blend3d/Inventor-2040-W/STL/Dave's 2040 VL53L1x 0-Deg Bracket.stl

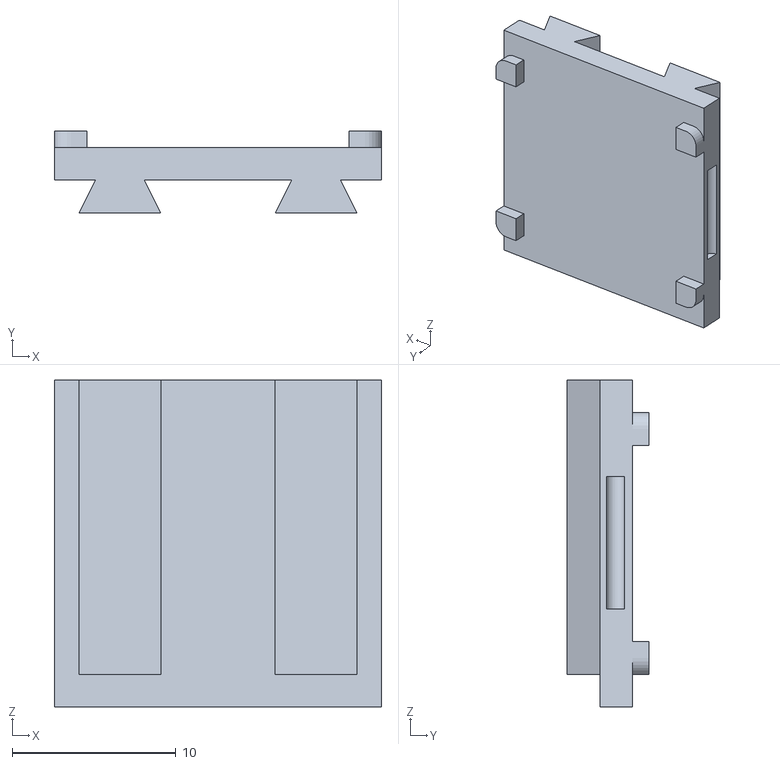
[picture p1: CAD file, 2026-10-23]
STL/Dave's 2040 VL53L1x 0-Deg Bracket.stl
20.0 x 5.00 x 20.0
