blend3d/Inventor-2040-W/STL/Dave's 2040 Travel Box Base r1.stl

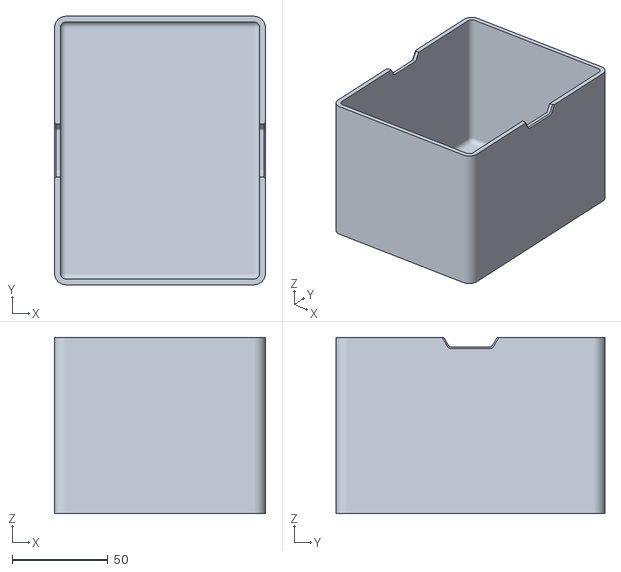
[picture p2: CAD file, 2026-10-19]
STL/Dave's 2040 Travel Box Base r1.stl
110.0 x 140.0 x 92.0
