blend3d/Inventor-2040-W/STL/Dave's 2040 Programming Stand r1.stl

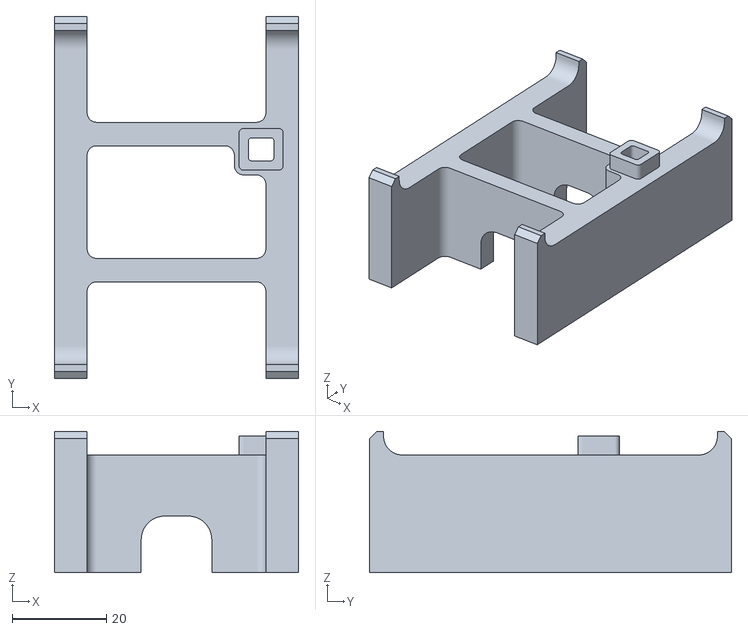
[picture p3: CAD file, 2026-10-19]
STL/Dave's 2040 Programming Stand r1.stl
52.0 x 77.0 x 30.0
