blend3d/Inventor-2040-W/STL/Dave's 2040 Batt Hold w_Locks r1.stl

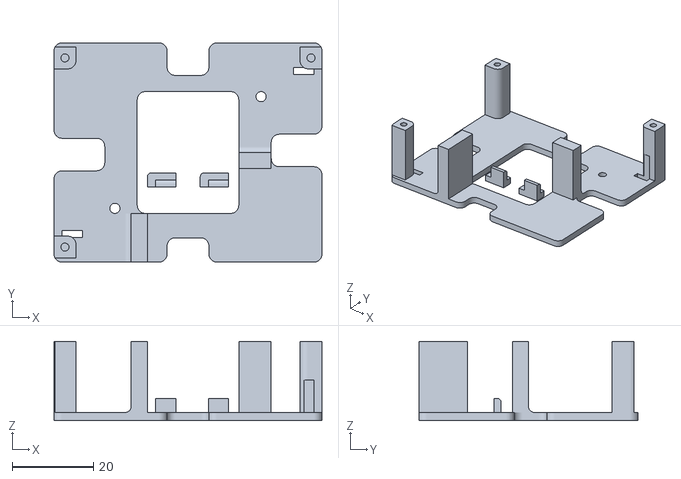
[picture p5: CAD file, 2026-05-22]
STL/Dave's 2040 Batt Hold w_Locks r1.stl
66.0 x 54.0 x 19.5
