blend3d/Inventor-2040-W/STL/Dave's 2040 Universal Front Bracket.stl

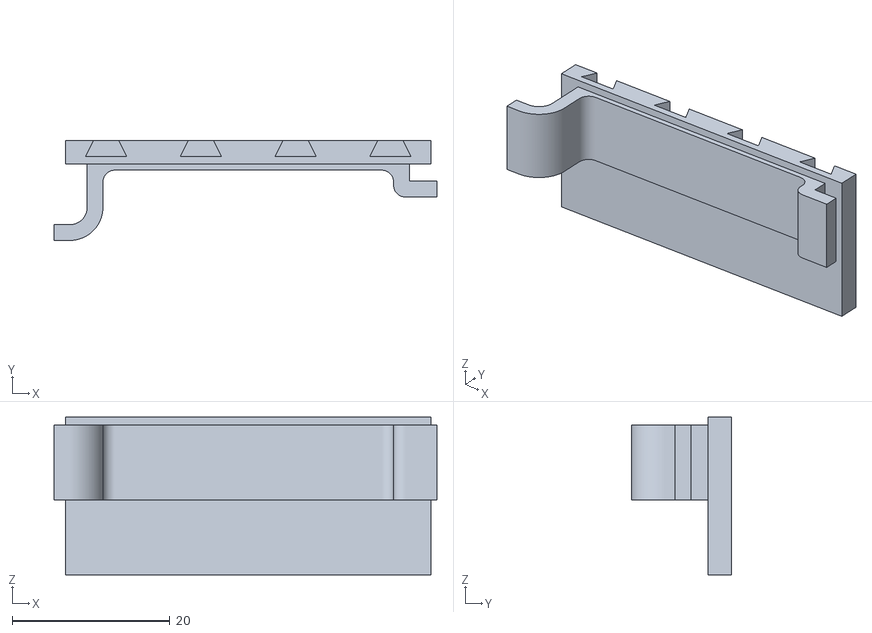
[picture p6: CAD file, 2026-05-22]
STL/Dave's 2040 Universal Front Bracket.stl
48.5 x 12.7 x 20.0
