blend3d/Inventor-2040-W/STL/Dave's 2040 VL53L1X Housing.stl

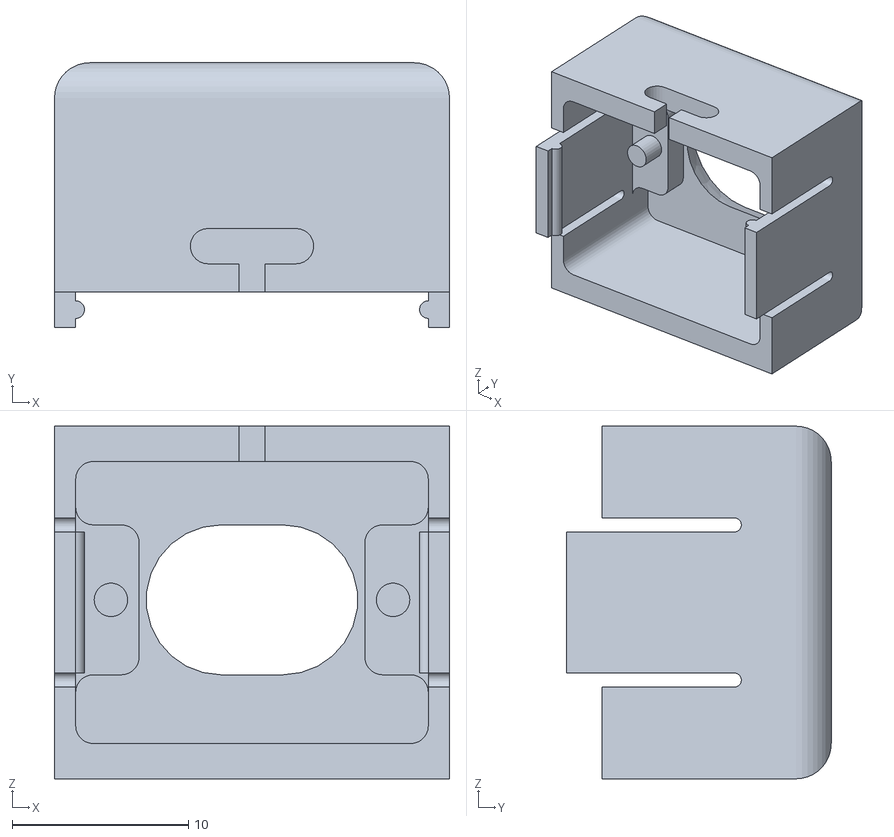
[picture p7: CAD file, 2026-05-22]
STL/Dave's 2040 VL53L1X Housing.stl
22.4 x 15.0 x 20.0
