blend3d/Inventor-2040-W/STL/Dave's 2040 24-Deg VL53L1X Mount Bracket.stl

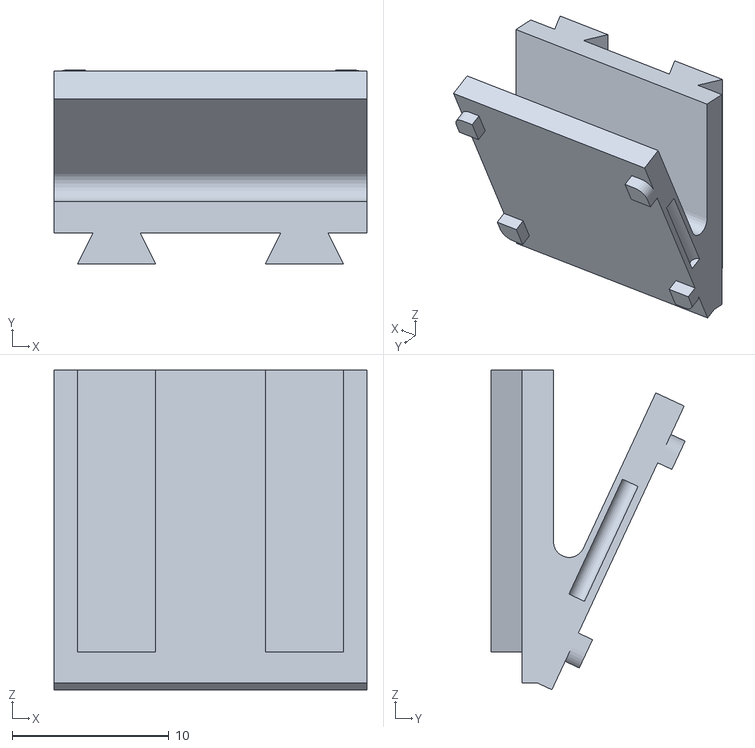
[picture p8: CAD file, 2026-05-22]
STL/Dave's 2040 24-Deg VL53L1X Mount Bracket.stl
20.0 x 12.4 x 20.4
