blend3d/Inventor-2040-W/STL/Dave's 2040 Chassis.stl

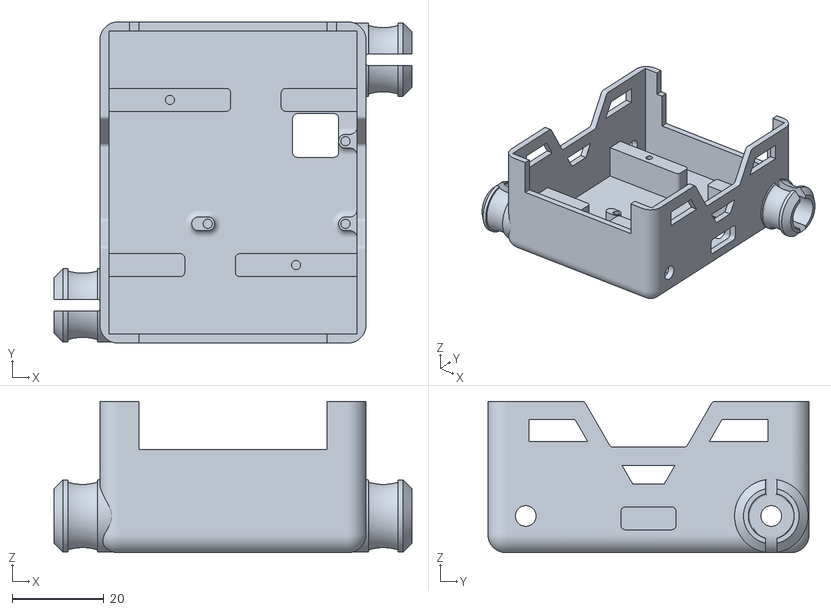
[picture p9: CAD file, 2026-05-22]
STL/Dave's 2040 Chassis.stl
78.0 x 70.0 x 33.0
