blend3d/Inventor-2040-W/STL/Dave's 2040 Sonar Bracket.stl

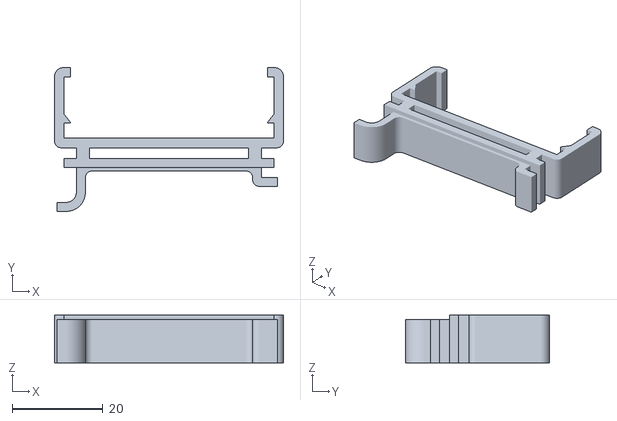
[picture p10: CAD file, 2026-05-22]
STL/Dave's 2040 Sonar Bracket.stl
50.4 x 31.6 x 10.5
