blend3d/Inventor-2040-W/(list of files, cad)

Other CAD files:
STL/Dave's 2040 Programming Stand.3mf
