blend3d/Inventor-2040-W/Build and Part Info/README.md

Pimoroni Inventor 2040/2350 W Board Information:

Github Repository - https://github.com/pimoroni/inventor

Library Reference - https://github.com/pimoroni/inventor/blob/main/docs/inventor.md

Micropython Examples - https://github.com/pimoroni/inventor/blob/main/examples/README.md

EzWiFi - https://github.com/pimoroni/inventor/blob/main/docs/ezwifi.md
