blend3d/Inventor-2040-W/Code/Basic Tests from Build PDF/README Astronauts and ISS.md

Create a lib directory (if not present) on your Pico W via Thonny.

Open the secrets.py file and insert your ssid and password between the quotes

Example:

    Change: ssid = "YOUR_WIFI_SSID"             To: ssid ="daves_router"
    Change: password = "YOUR_WIFI_PASSWORD"     To: password = "ou812#"

Once this is completed save the file. navigate to the lib folder on your pico and upload your secrets.py file.

Run the astronauts_and_iss_r2.py

Note: this project is pulling API json data from: http://open-notify.org/Open-Notify-API/
