blend3d/Inventor-2040-W/Build and Part Info/Inventor 2040 SMARS Build Guide.pdf

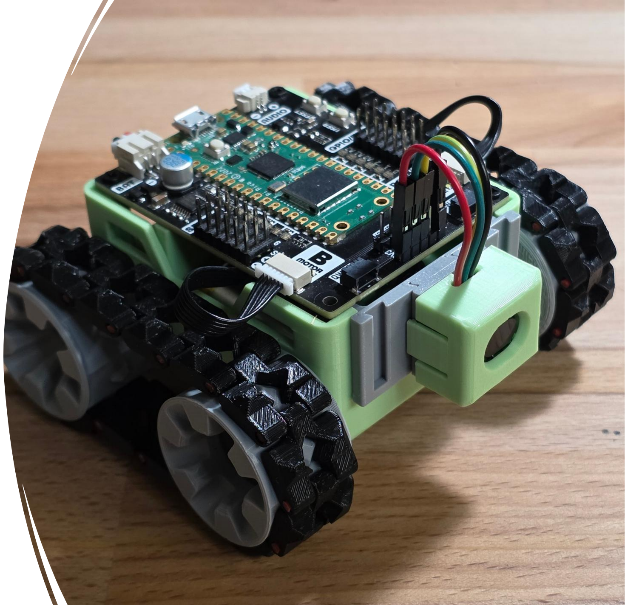
[picture p11: figure]

# Inventor

2040

# SMARS Build Guide

# Table of Contents

Build Guide:
1. Installing Charging PCBA and Battery
2. Install Motors
3. Install Battery Plate
4. Install Gearhead Motor Encoder Cables
5. Install Front Mounting Bracket
6. Assembling Speaker to Inventor 2040 PCBA
7. Installing Inventor 2040 PCBA
8. Install Slave Wheels
9. Assembling Tank Tracks
10. Installing Drive Wheels and Tank Tracks
11. Assembling VX53L1x Time of Flight (TOF) Sensor
12. Installing the VX53L1x TOF Sensor Assembly
13. Testing and Code Installation: Getting your SMARS to Come Alive

Appendix A: Component Information
Appendix B: Various Part Drawings

Installing Charging PCBA
and Battery

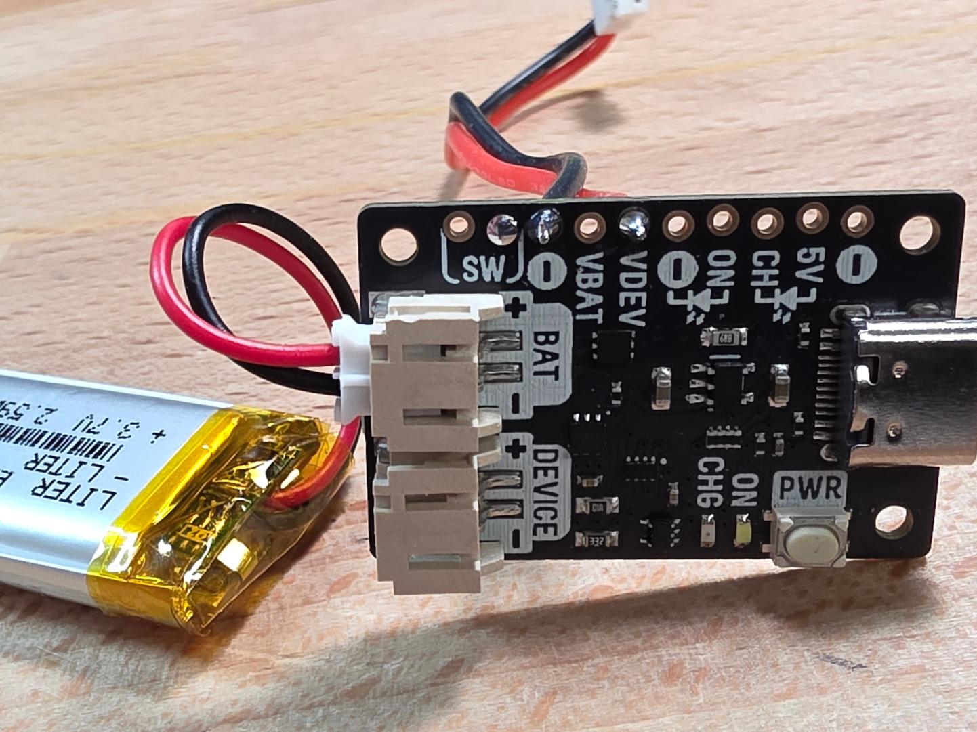
[picture p12: figure]

Plug the battery connector into the LiPo Amigo Pro Charging PCBA

Note: Polarity and Connector Orientation.

Test by pushing the PWR button. If correct the “ON” LED will light up white when on. Turn off before next steps.

Next plug into a USB C power source. The “CHG” LED should Illuminate red until battery is charged. Battery supplied was charged so the LED may not stay on very long.

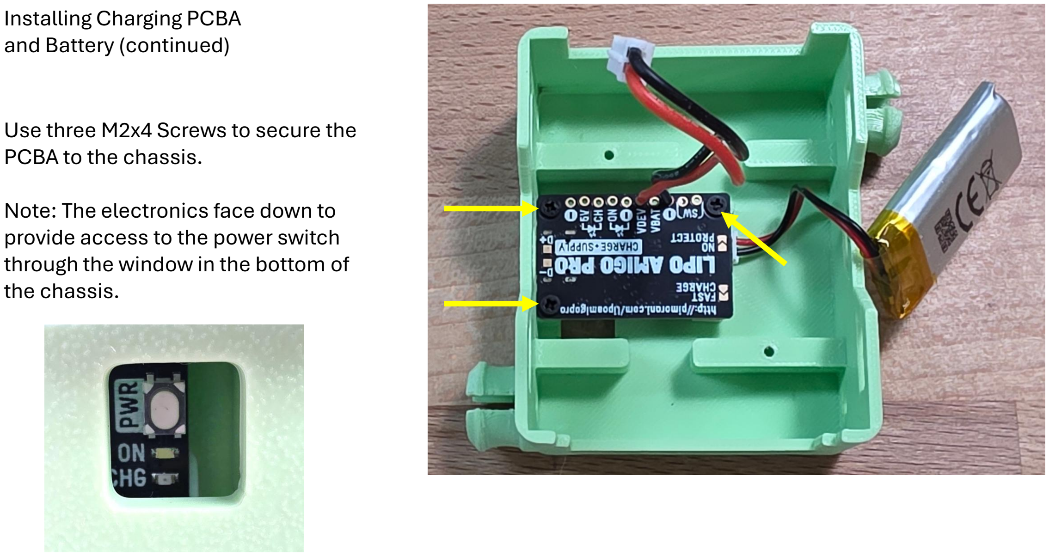
[picture p13: page 4]

Installing Charging PCBA
and Battery (continued)

Use three M2x4 Screws to secure the PCBA to the chassis.

Note: The electronics face down to provide access to the power switch through the window in the bottom of the chassis.

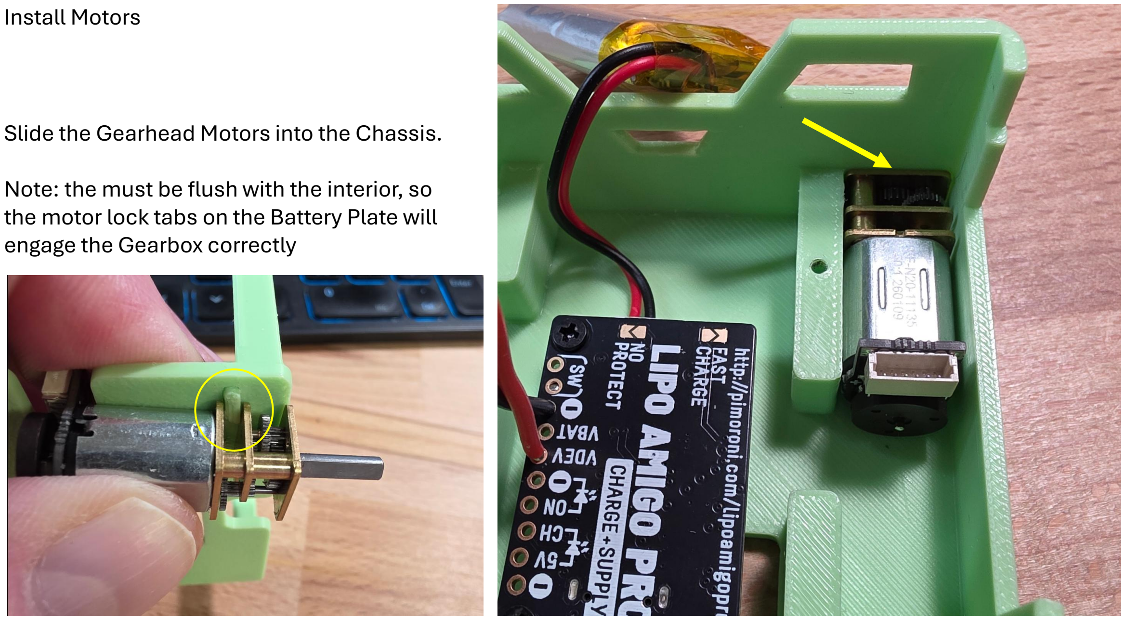
[picture p14: page 5]

Install Motors

Slide the Gearhead Motors into the Chassis.

Note: the must be flush with the interior, so the motor lock tabs on the Battery Plate will engage the Gearbox correctly

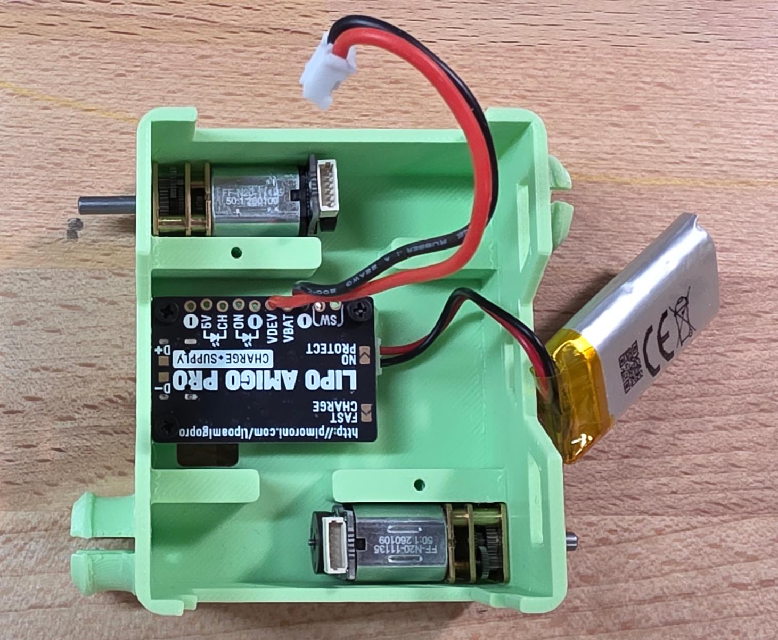
[picture p15: figure]

Install Motors (continued)

Your Chassis should look like this with the motors opposite each other and the power components in place.

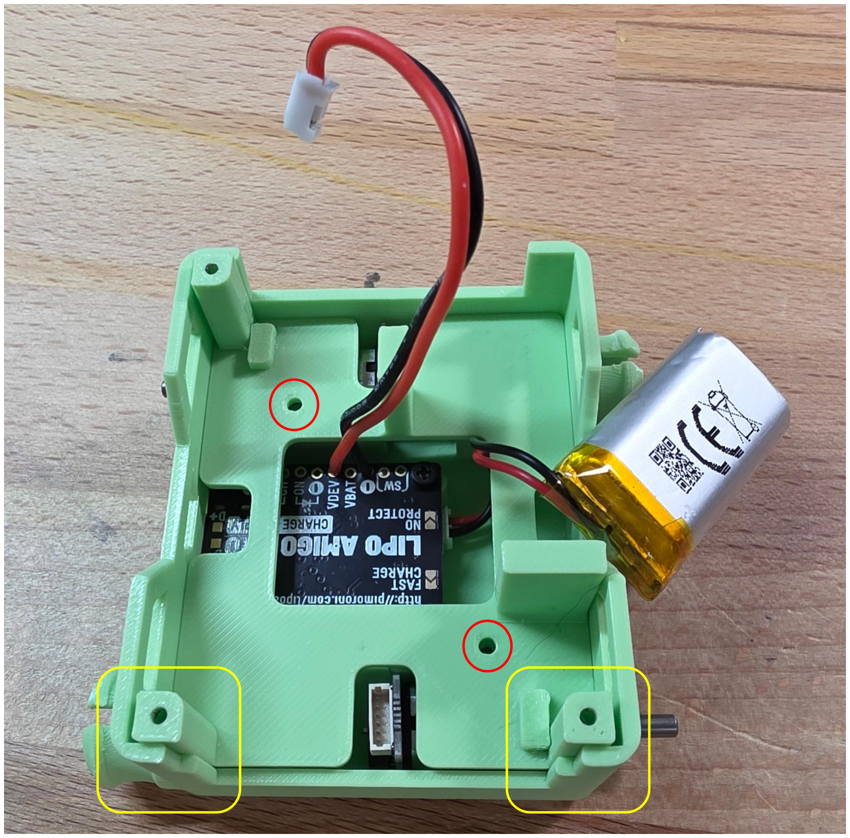
[picture p16: figure]

Install Battery Plate

Once the Gearhead Motors are in place install the Battery Plate as shown. Make sure that the Battery and Power wiring go through the center of the plate. Also, that the notched ends in the chassis have two mounting posts near them (yellow boxes).

Note: Ensure the Motors are flush with the interior, so the motor lock tabs on the Battery Plate will engage the Gearbox correctly. You can pull on the shafts as you push the plate into the chassis.

Once the plate is seated in place secure it with two screws (red circles).

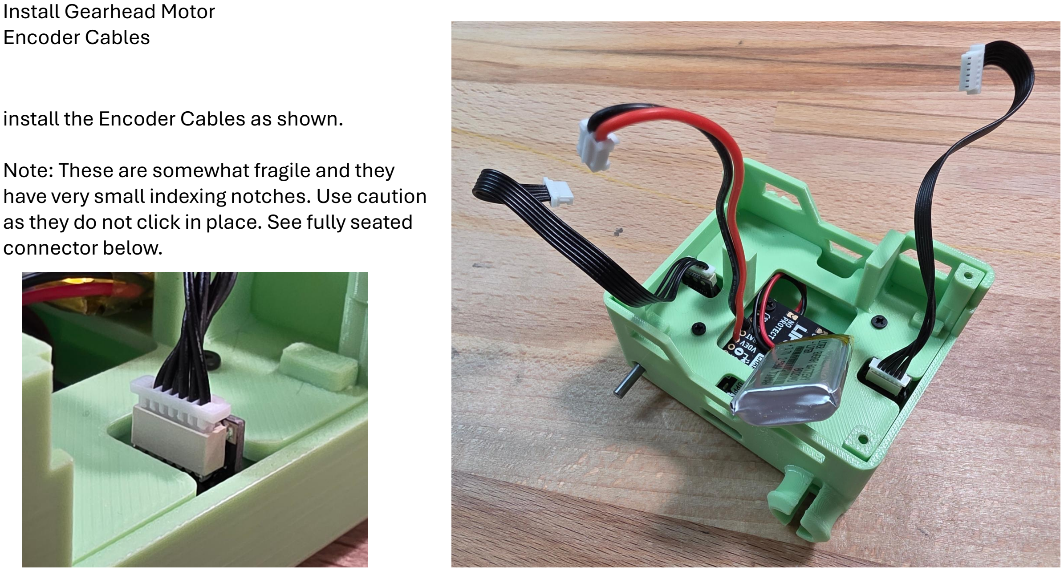
[picture p17: page 8]

Install Gearhead Motor
Encoder Cables

install the Encoder Cables as shown.

Note: These are somewhat fragile and they have very small indexing notches. Use caution as they do not click in place. See fully seated connector below.

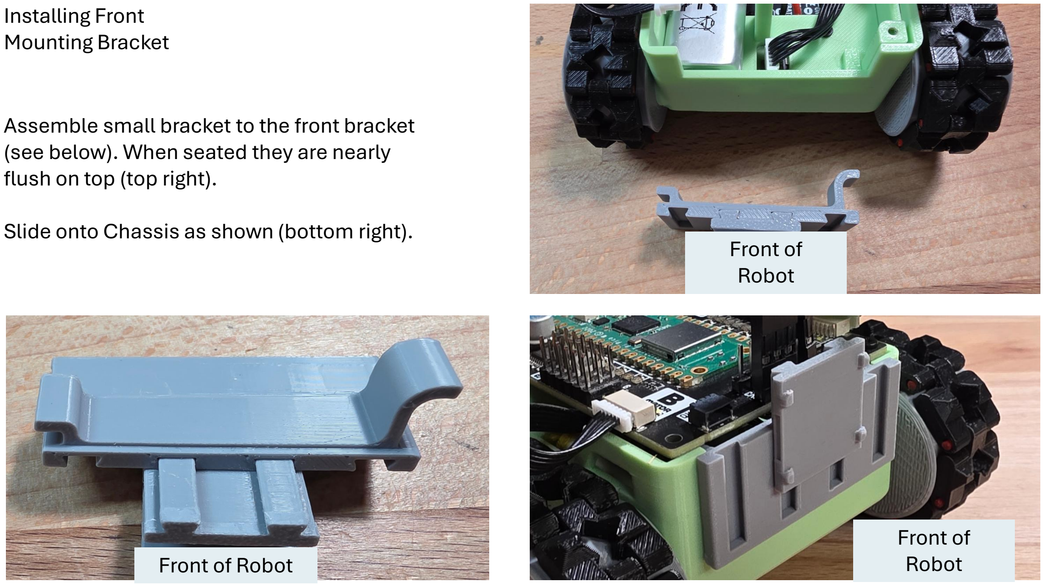
[picture p18: page 9]

Installing Front
Mounting Bracket

Assemble small bracket to the front bracket (see below). When seated they are nearly flush on top (top right).

Slide onto Chassis as shown (bottom right).

Front of
Robot

Front of
Robot

Front of Robot

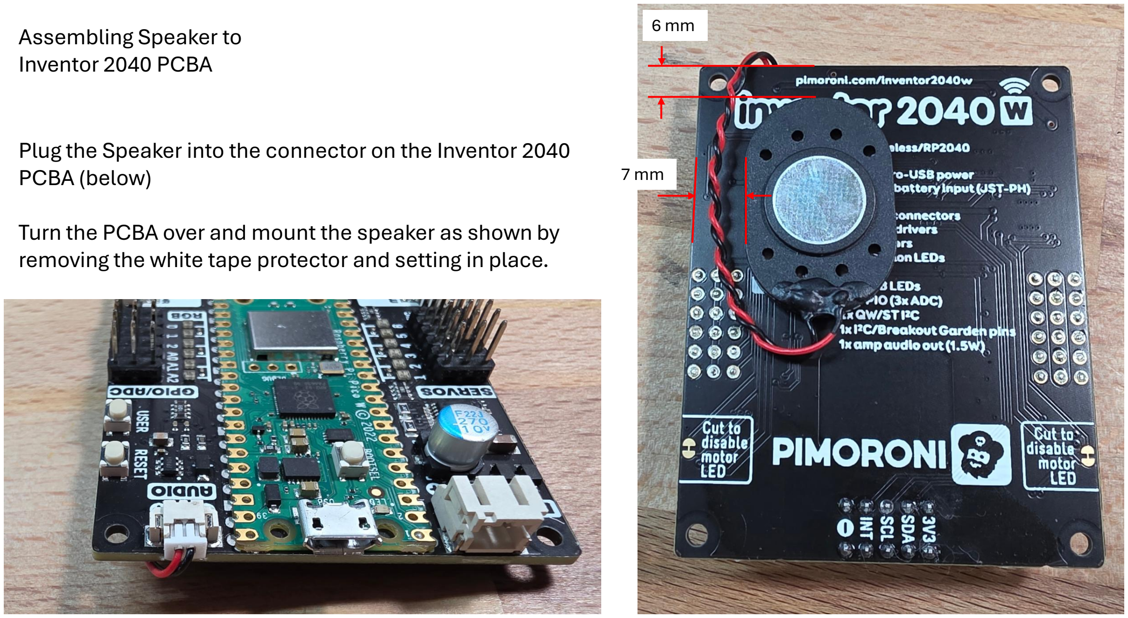
[picture p19: page 10]

Assembling Speaker to
Inventor 2040 PCBA

Plug the Speaker into the connector on the Inventor 2040 PCBA (below)

Turn the PCBA over and mount the speaker as shown by removing the white tape protector and setting in place.

6 mm

7 mm

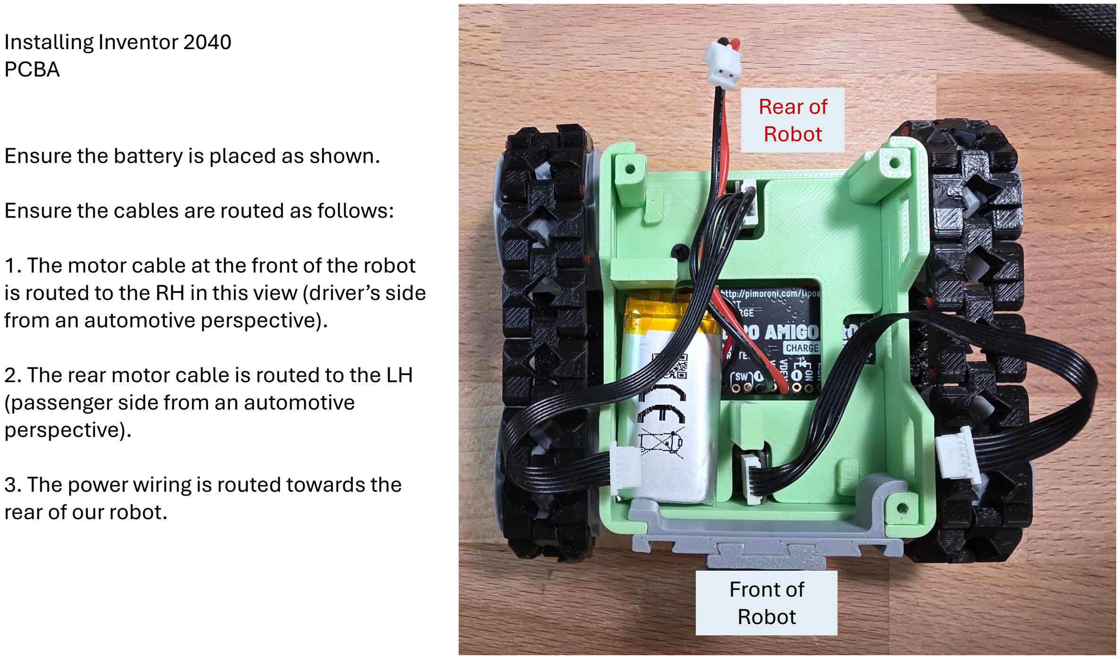
[picture p20: page 11]

Installing Inventor 2040
PCBA

Ensure the battery is placed as shown.

Ensure the cables are routed as follows:

1. The motor cable at the front of the robot is routed to the RH in this view (driver’s side from an automotive perspective).
2. The rear motor cable is routed to the LH (passenger side from an automotive perspective).
3. The power wiring is routed towards the rear of our robot.

Rear of
Robot

Front of
Robot

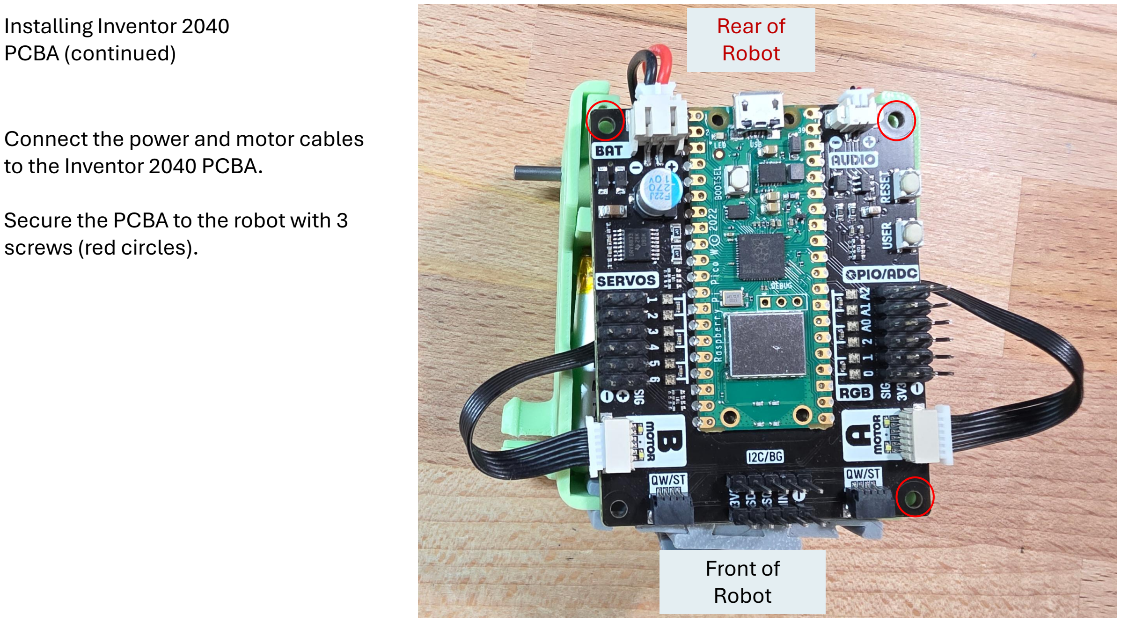
[picture p21: page 12]

Installing Inventor 2040
PCBA (continued)

Connect the power and motor cables to the Inventor 2040 PCBA.

Secure the PCBA to the robot with 3 screws (red circles).

Front of
Robot

Rear of
Robot

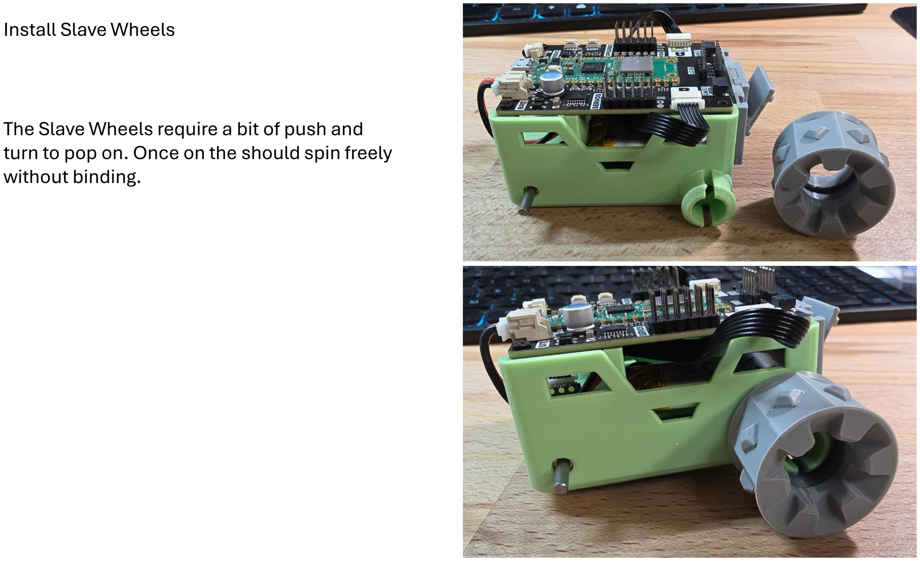
[picture p22: page 13]

Install Slave Wheels

The Slave Wheels require a bit of push and turn to pop on. Once on the should spin freely without binding.

Assembling Tank Tracks

The Tank Tracks are made of 16 segments per track. They use PLA filament as their link points. The parts are mirrored so that you can build a set of RH and LH tracks, or a set of alternating staggered tracks.

Included in the Kit are 17 RH, and 17 LH track segments so that you have one spare per type.

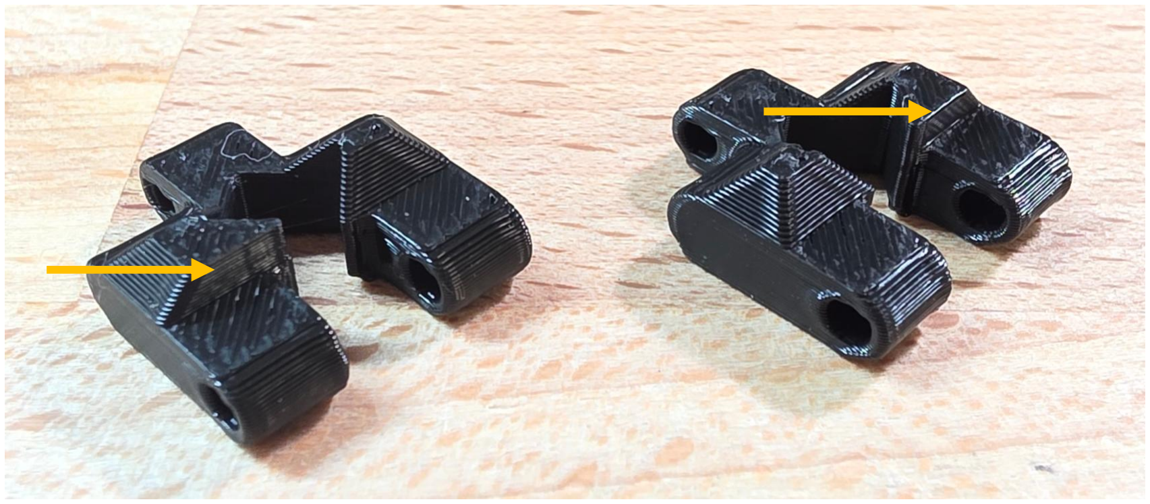
[picture p23: figure]

Note how the track
segments have a
squared off portion
on opposite sides.

Assembling Tank Tracks (continued)

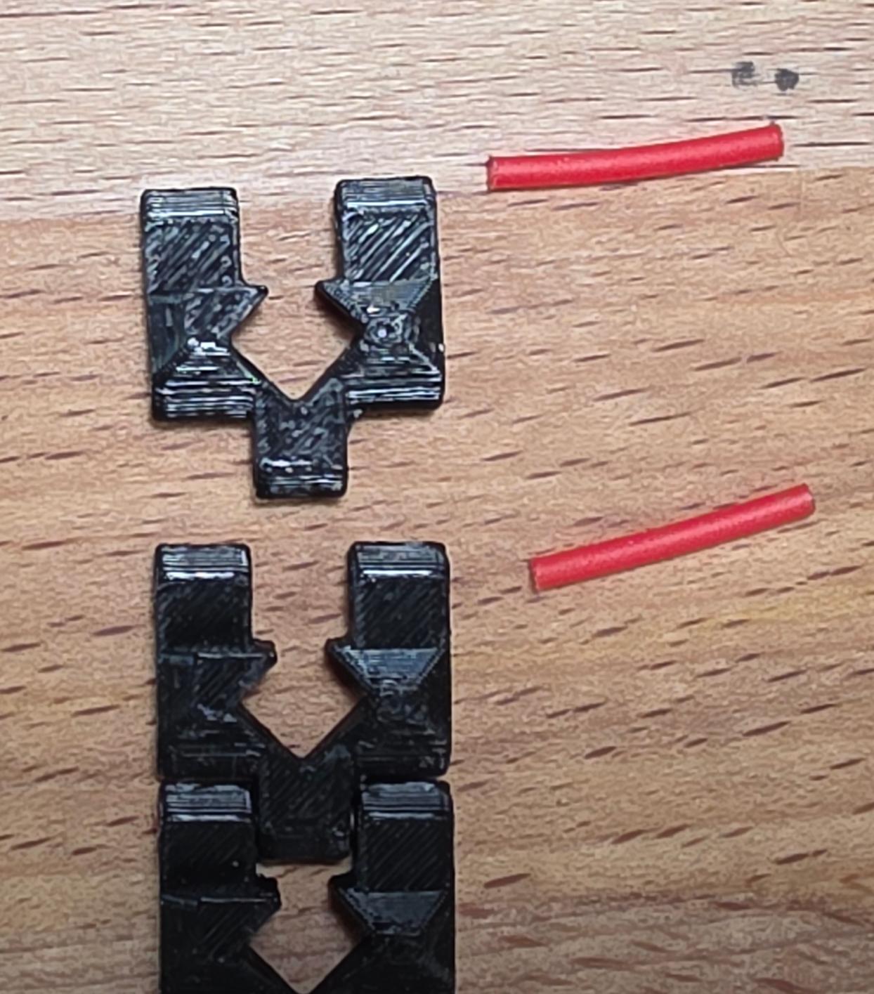
[picture p24: figure]

PLA filament is used as the link points between segments.

Included in the Kit are both yellow and red PLA to use based on preference.

Simply line up the tracks and push the PLA in in until it is flush on the other side. When inserted cut the piece off with and Xacto Knife.

Note: A soldering iron or wood burner can melt the ends to provide a nicer end once cut.

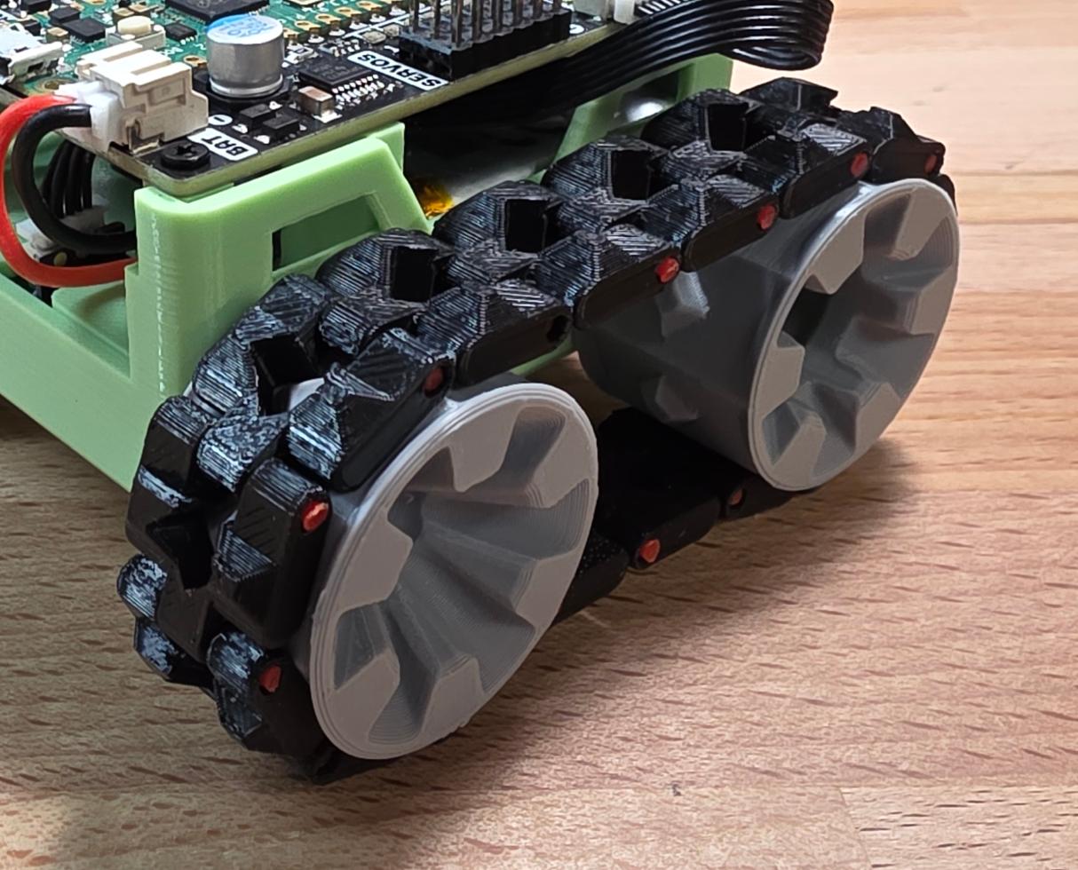
[picture p25: figure]

Installing Drive Wheels and
Tank Tracks

The Master Wheels and Tank Tracks can be installed in two ways:

1. Install the Wheels first to the D-Shafts, then open the tracks by pulling a link pin. Wrap the tracks around the wheels and reinstall the link pin.
2. Loop the Track around the wheels and push the wheels onto the D-Shaft.

Note, The diamonds on the wheels coincide with the holes in the track. Also, the squared edge should be installed so that the track can grab and help pull the robot along uneven surfaces.

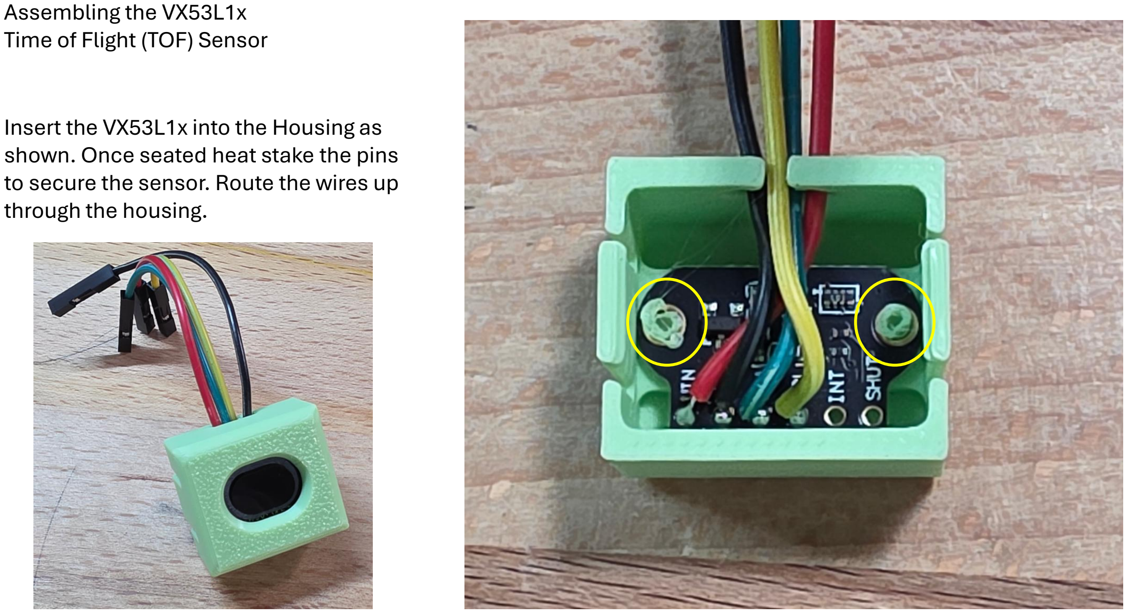
[picture p26: page 17]

Assembling the VX53L1x
Time of Flight (TOF) Sensor

Insert the VX53L1x into the Housing as shown. Once seated heat stake the pins to secure the sensor. Route the wires up through the housing.

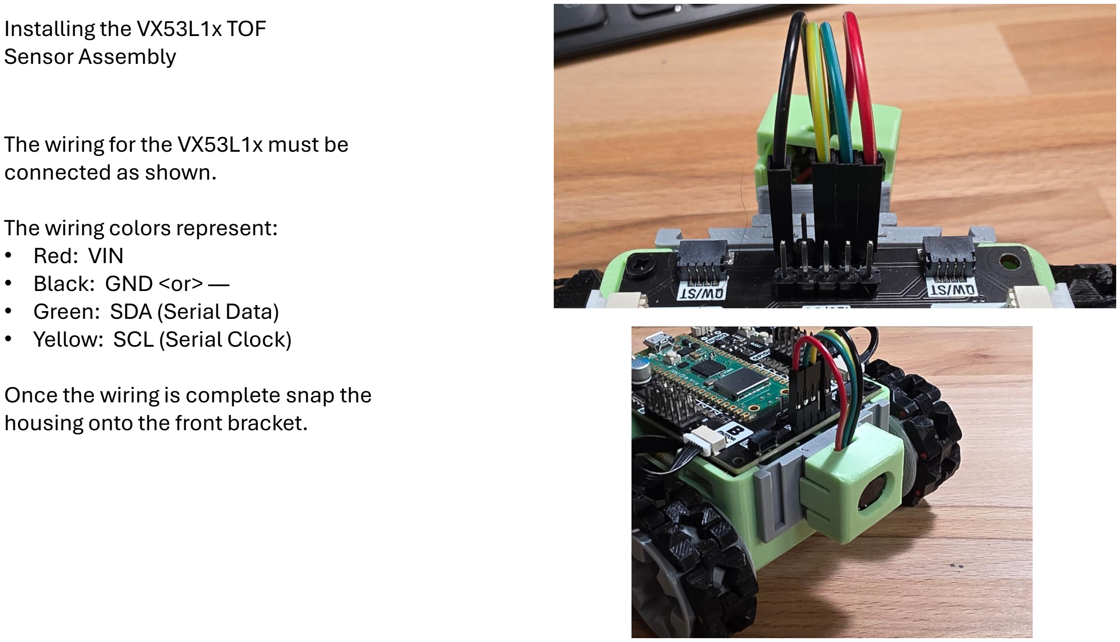
[picture p27: page 18]

Installing the VX53L1x TOF
Sensor Assembly

The wiring for the VX53L1x must be connected as shown.

The wiring colors represent:
- Red: VIN
- Black: GND <or> ―
- Green: SDA (Serial Data)
- Yellow: SCL (Serial Clock)

Once the wiring is complete snap the housing onto the front bracket.

1. Install Thonny v5.0.0
2. Create a lib folder on Inventor 2040 W
3. Fill out the ssid name and ssid password in the secrets.py file.
4. Upload the secrets.py to the lib folder on your Inventor 2040 W
5. Run the following files to test basic functionality:
- astronauts_and_iss_r2.py
- Pulls Astronaut and ISS data from an API on the Web (may need to be restarted a few times)
- tone_song.py
- Plays a short tune through the speaker
- vl53l1x_distance_ranging.py
- Reports distance in mm
- rgb_led_test.py
- Cycles RGB LEDs through the color spectrum then shuts LEDs off
- motor_position_wave.py
- Tests motors
- main.py
- Upload to SMARS, under battery power the robot will move and avoid objects
6. Happy coding and expanding on your Inventor 2040 W or 2350 W SMARS

Getting your SMARS to make noise, light the LEDs, connect to a WEB API,

## demonstrate the motors , and add a simple free ranging robot program

See the:
“Inventor Function Cheatsheet.xlsx” for Pimoroni’s Inventor 2040/2350 W embedded commands and other info

# Appendix A: Component Information

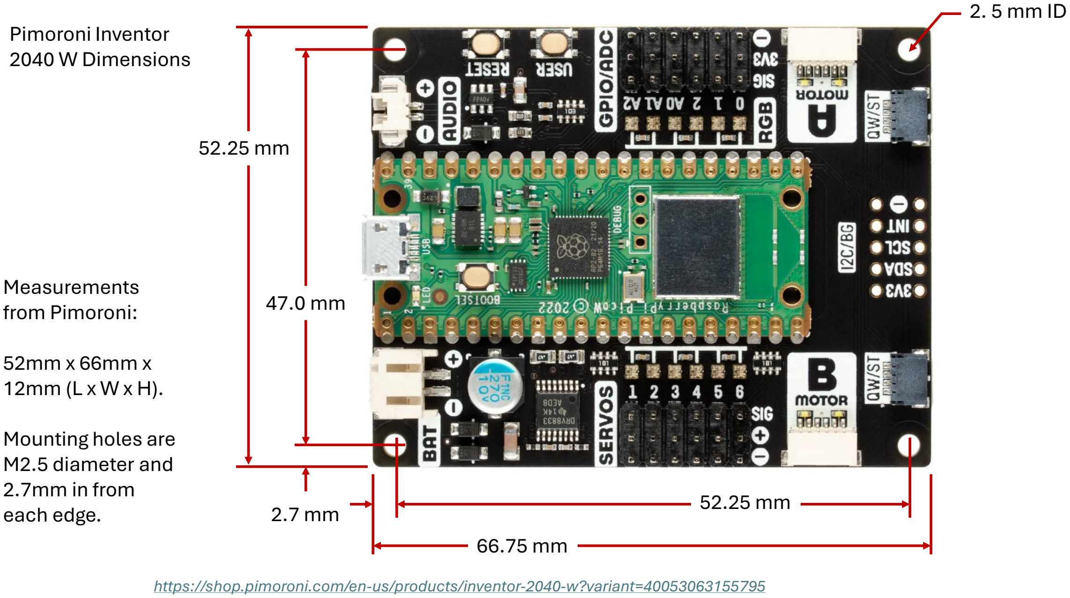
[picture p28: figure]
Pimoroni Inventor 2040 W Dimensions; Measurements from Pimoroni:; Mounting holes are M2.5 diameter and 2.7mm in from each edge.; https://shop.pimoroni.com/en-us/products/inventor-2040-w?variant=40053063155795

LiPo Amigo Pro Dimensions

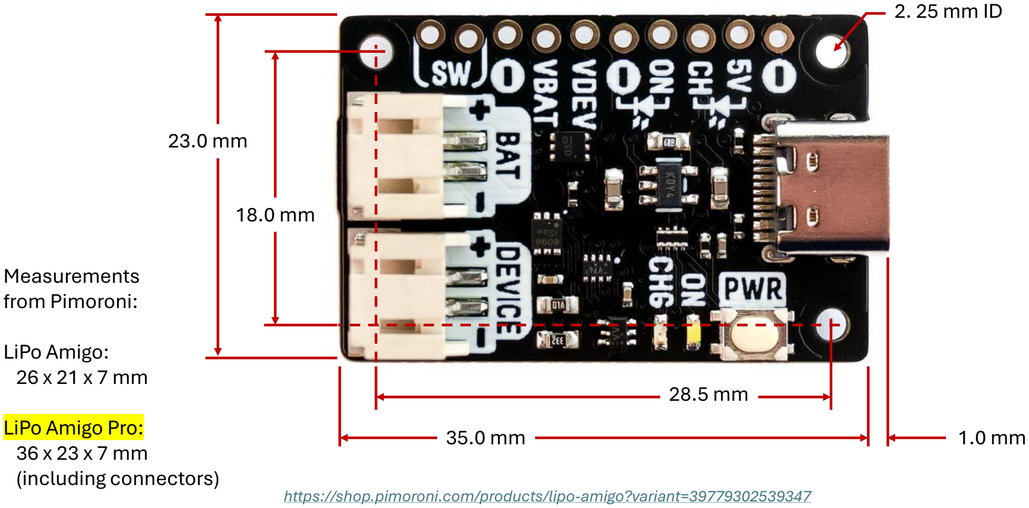
[picture p29: figure]
Measurements from Pimoroni:; LiPo Amigo: 26 x 21 x 7 mm; LiPo Amigo Pro: 36 x 23 x 7 mm (including connectors); https://shop.pimoroni.com/products/lipo-amigo?variant=39779302539347
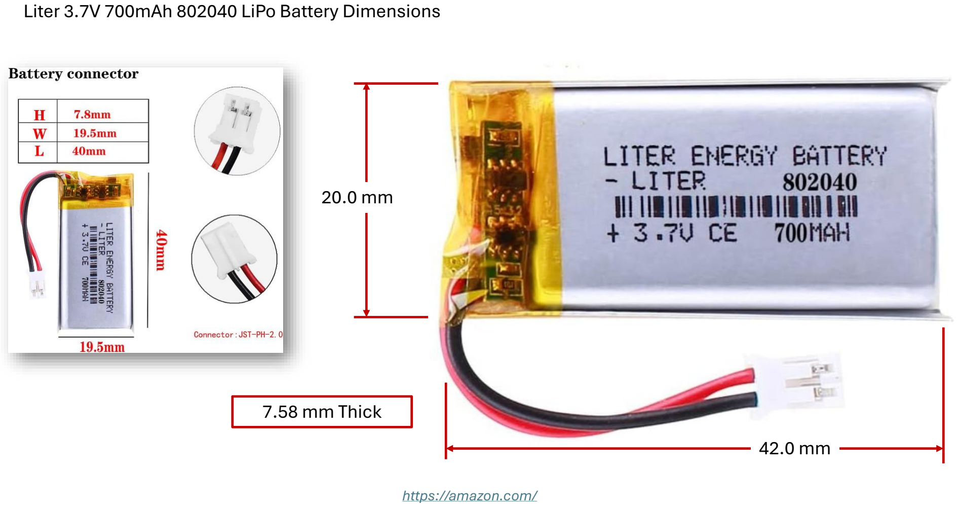
[picture p30: page 23]

Liter 3.7V 700mAh 802040 LiPo Battery Dimensions

20.0 mm

42.0 mm

7.58 mm Thick

https://amazon.com/ (https://a.co/d/00v8WFwo)

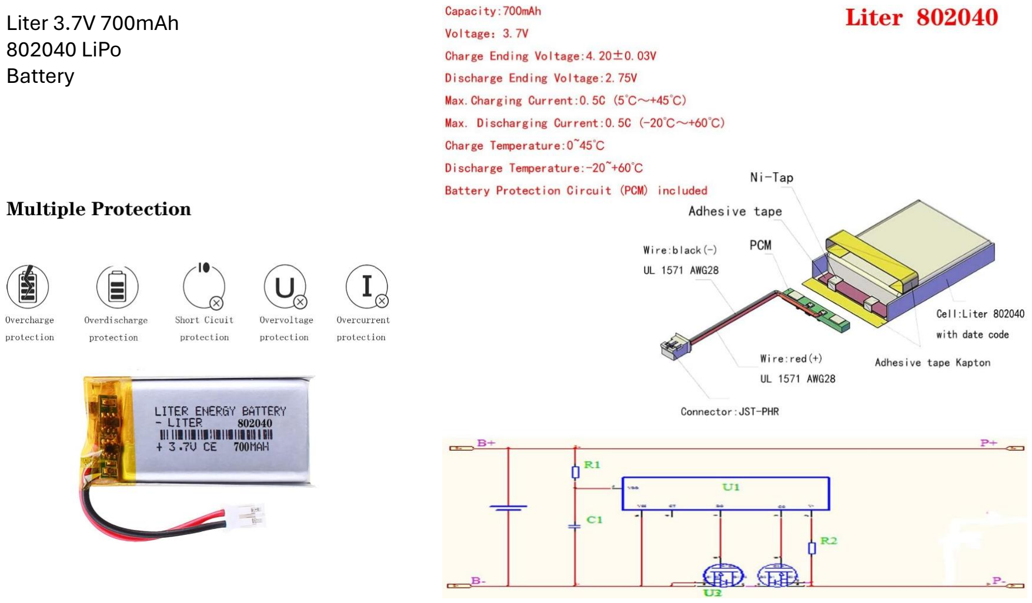
[picture p31: page 24]

Liter 3.7V 700mAh
802040 LiPo
Battery

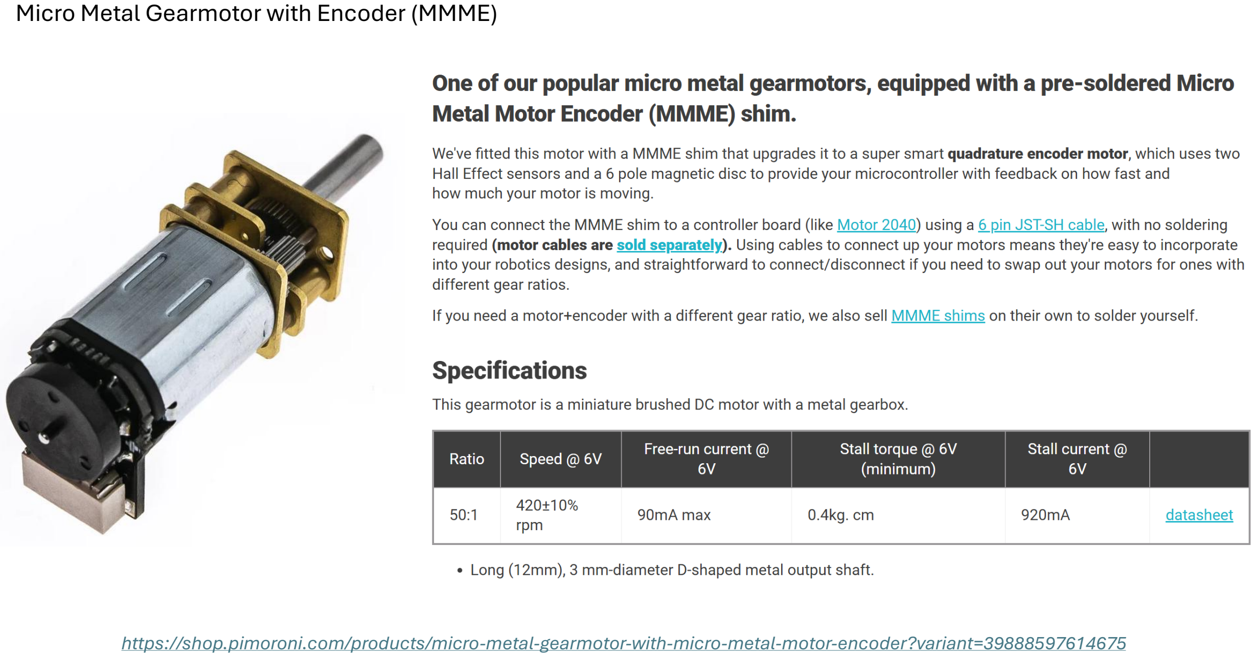
[picture p32: page 25]

Micro Metal Gearmotor with Encoder (MMME)

https://shop.pimoroni.com/products/micro-metal-gearmotor-with-micro-metal-motor-encoder?variant=39888597614675

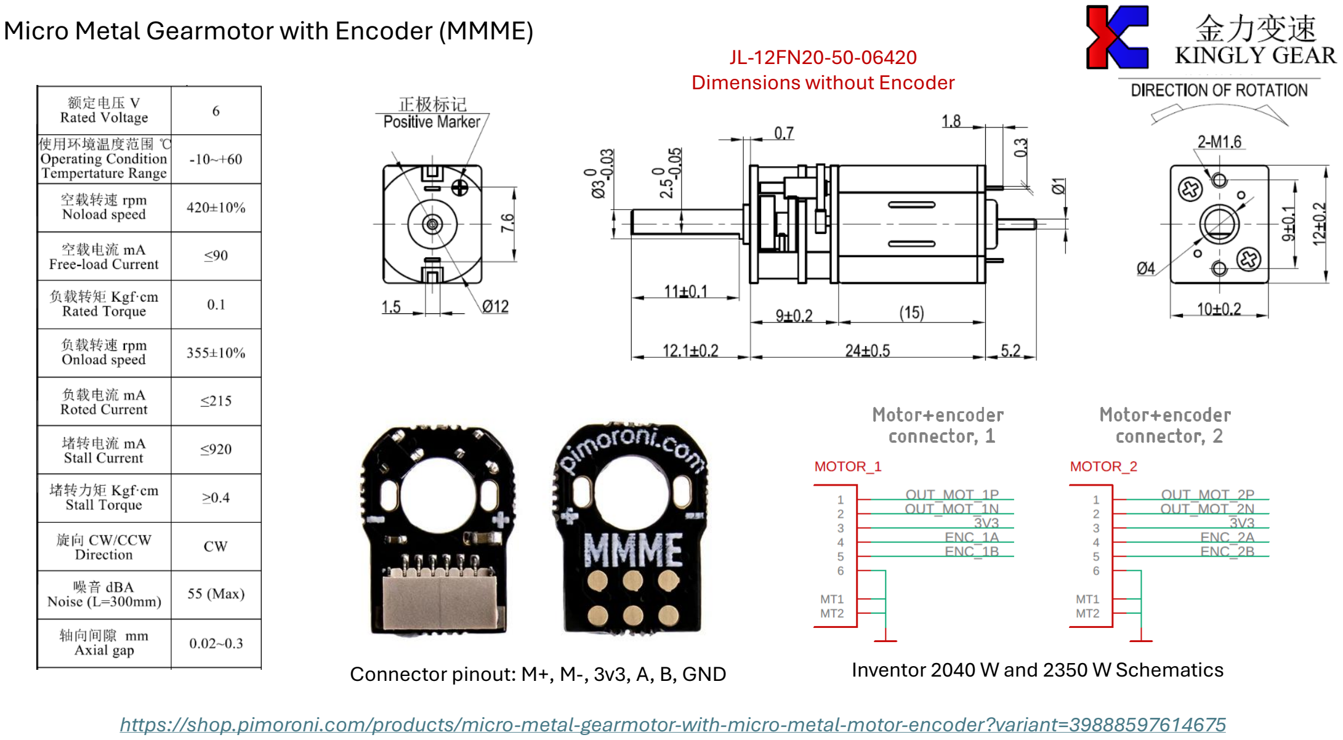
[picture p33: page 26]

Micro Metal Gearmotor with Encoder (MMME)

https://shop.pimoroni.com/products/micro-metal-gearmotor-with-micro-metal-motor-encoder?variant=39888597614675

Connector pinout: M+, M-, 3v3, A, B, GND

JL-12FN20-50-06420
Dimensions without Encoder

Inventor 2040 W and 2350 W Schematics

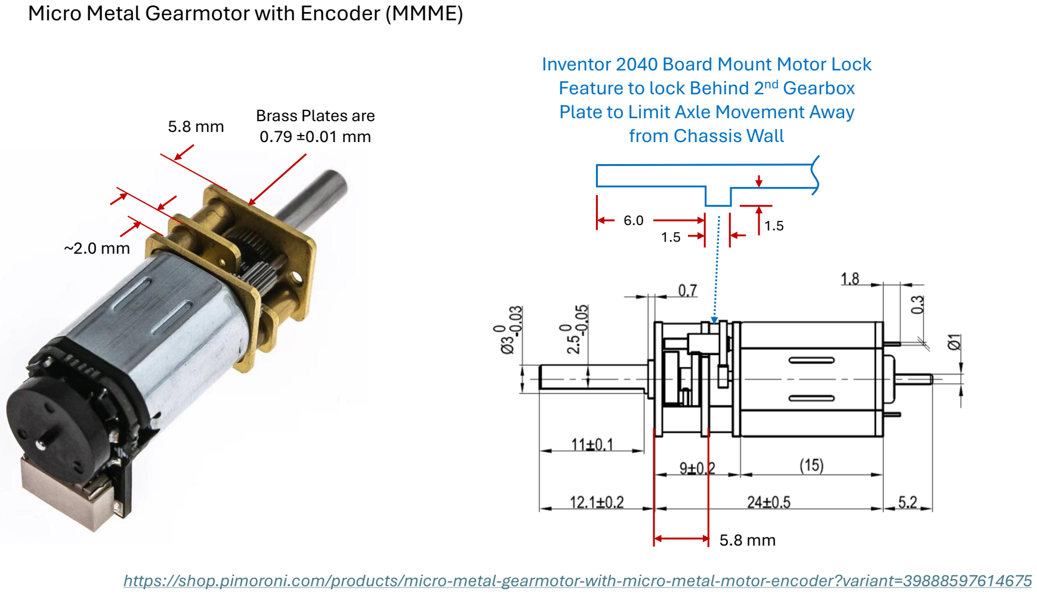
[picture p34: page 27]

Brass Plates are
0.79 ±0.01 mm 5.8 mm

~2.0 mm

Micro Metal Gearmotor with Encoder (MMME)

https://shop.pimoroni.com/products/micro-metal-gearmotor-with-micro-metal-motor-encoder?variant=39888597614675

Inventor 2040 Board Mount Motor Lock Feature to lock Behind 2nd Gearbox Plate to Limit Axle Movement Away from Chassis Wall

5.8 mm

1.5
1.5

6.0

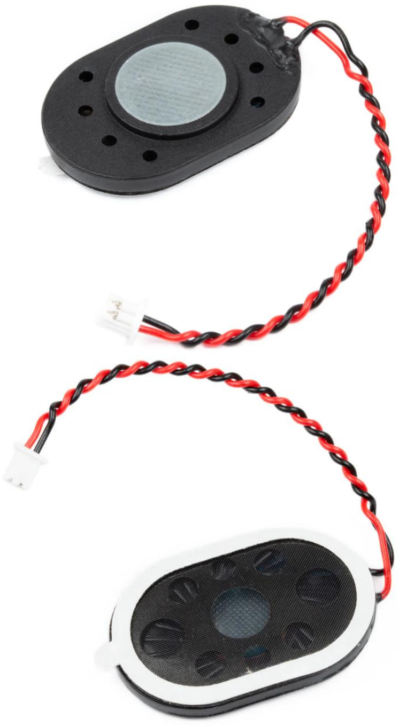
[picture p35: figure]

https://shop.pimoroni.com/products/mini-speaker-8-1w?variant=40053581938771

Adhesive Backed Mini Speaker 8Ω (1W)

A teeny speaker, great for embedded microcontroller projects.

We use this tiny speaker on our Pirate Audio: Speaker (https://shop.pimoroni.com/products/pirate-audio-mini-speaker) and it packs a surprising punch for its size! It has a Picoblade-compatible 2-pin connector, so it's easy to plug into things without the need for soldering or fiddling with screw connectors.

It also works great with Inventor 2350 (https://shop.pimoroni.com/products/inventor-2350-w) and Tiny FX! (https://shop.pimoroni.com/collections/tiny-fx)
- Dimensions: 30 x 20 x 4.5mm
- Impedence: 8 ohm
- Power: 1W max
- (https://cdn.shopify.com/s/files/1/0174/1800/files/mini-speaker.pdf?v=1656491999) Datasheet (https://cdn.shopify.com/s/files/1/0174/1800/files/mini-speaker.pdf?v=1656491999) (note our speaker is 4.5mm thick not 5.4mm)

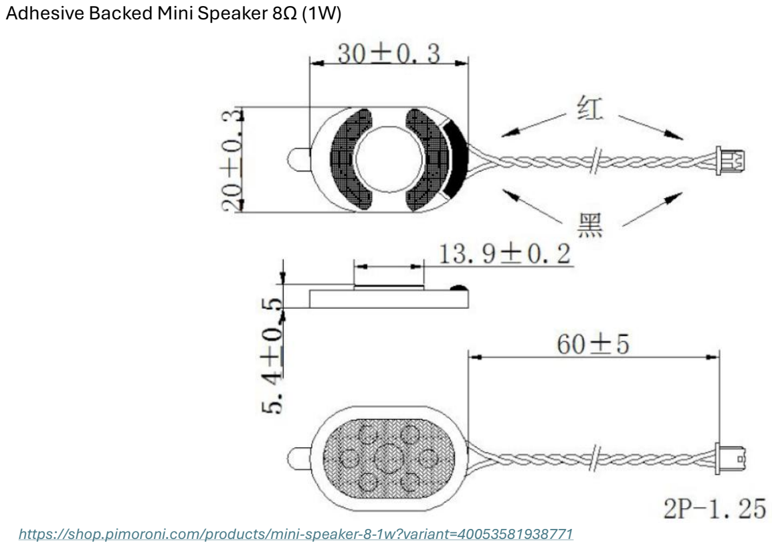
[picture p36: page 29]

https://shop.pimoroni.com/products/mini-speaker-8-1w?variant=40053581938771

Adhesive Backed Mini Speaker 8Ω (1W)

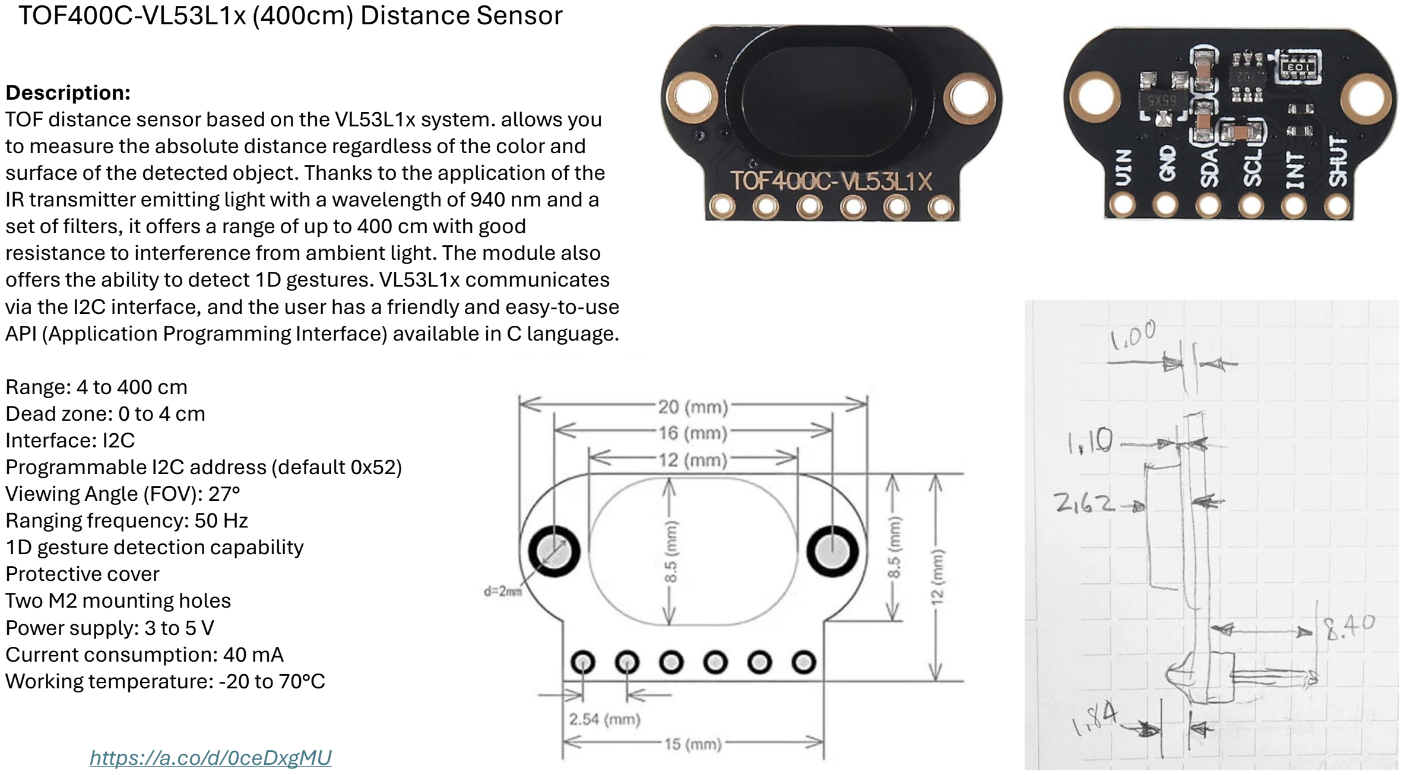
[picture p37: page 30]

https://a.co/d/0ceDxgMU

TOF400C-VL53L1x (400cm) Distance Sensor

Description:
TOF distance sensor based on the VL53L1x system. allows you to measure the absolute distance regardless of the color and surface of the detected object. Thanks to the application of the IR transmitter emitting light with a wavelength of 940 nm and a set of filters, it offers a range of up to 400 cm with good resistance to interference from ambient light. The module also offers the ability to detect 1D gestures. VL53L1x communicates via the I2C interface, and the user has a friendly and easy-to-use API (Application Programming Interface) available in C language.

Range: 4 to 400 cm
Dead zone: 0 to 4 cm
Interface: I2C
Programmable I2C address (default 0x52) Viewing Angle (FOV): 27°
Ranging frequency: 50 Hz
1D gesture detection capability Protective cover
Two M2 mounting holes
Power supply: 3 to 5 V
Current consumption: 40 mA Working temperature: -20 to 70°C

# Appendix B: Various Part Drawings

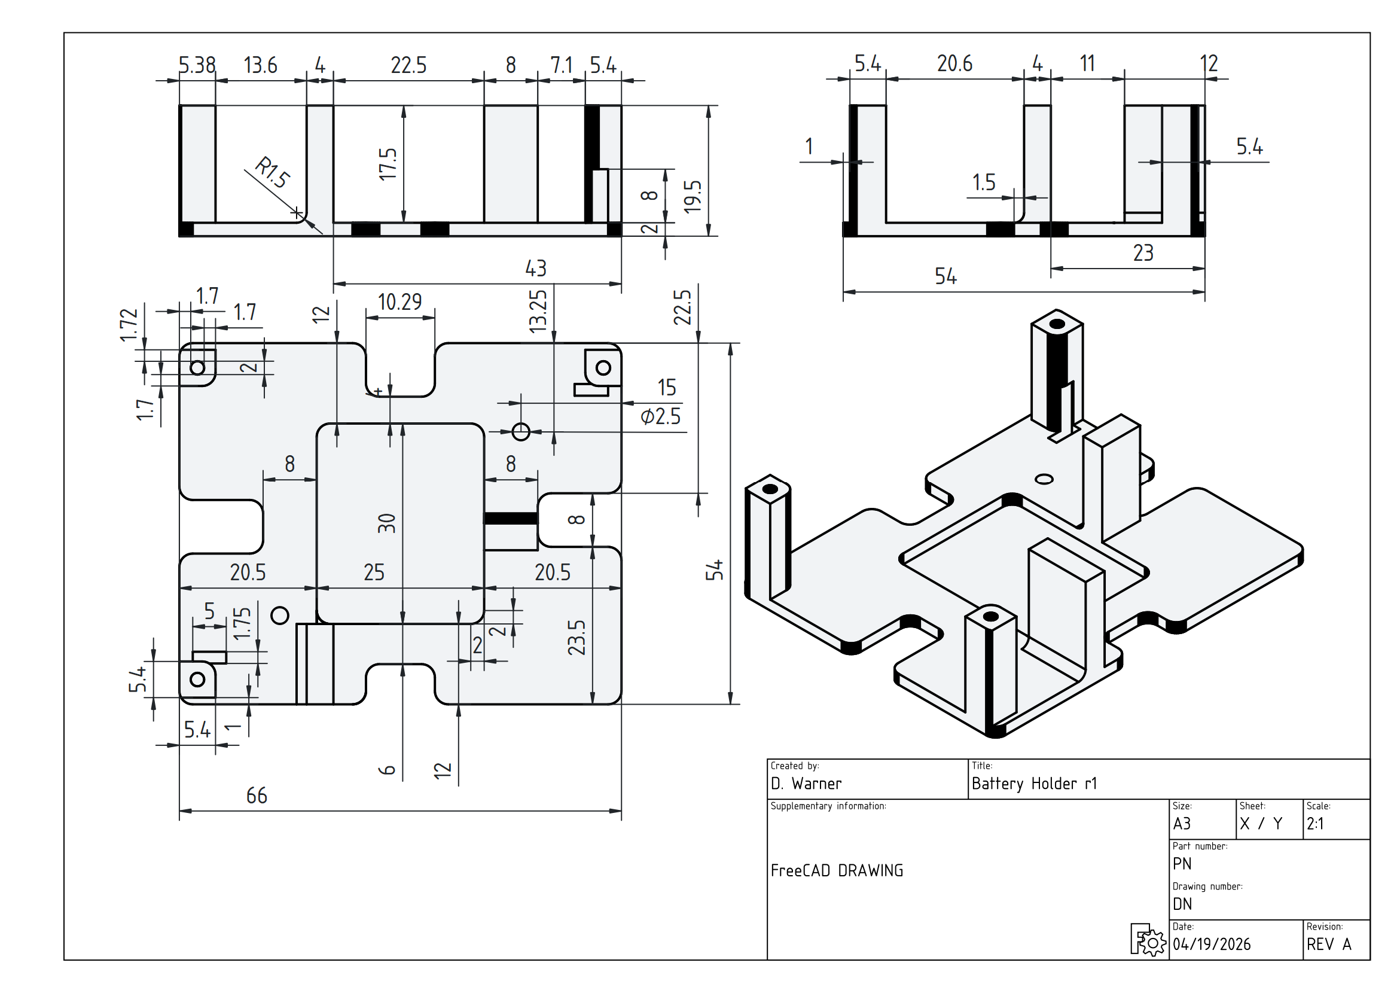
[picture p38: page 32]
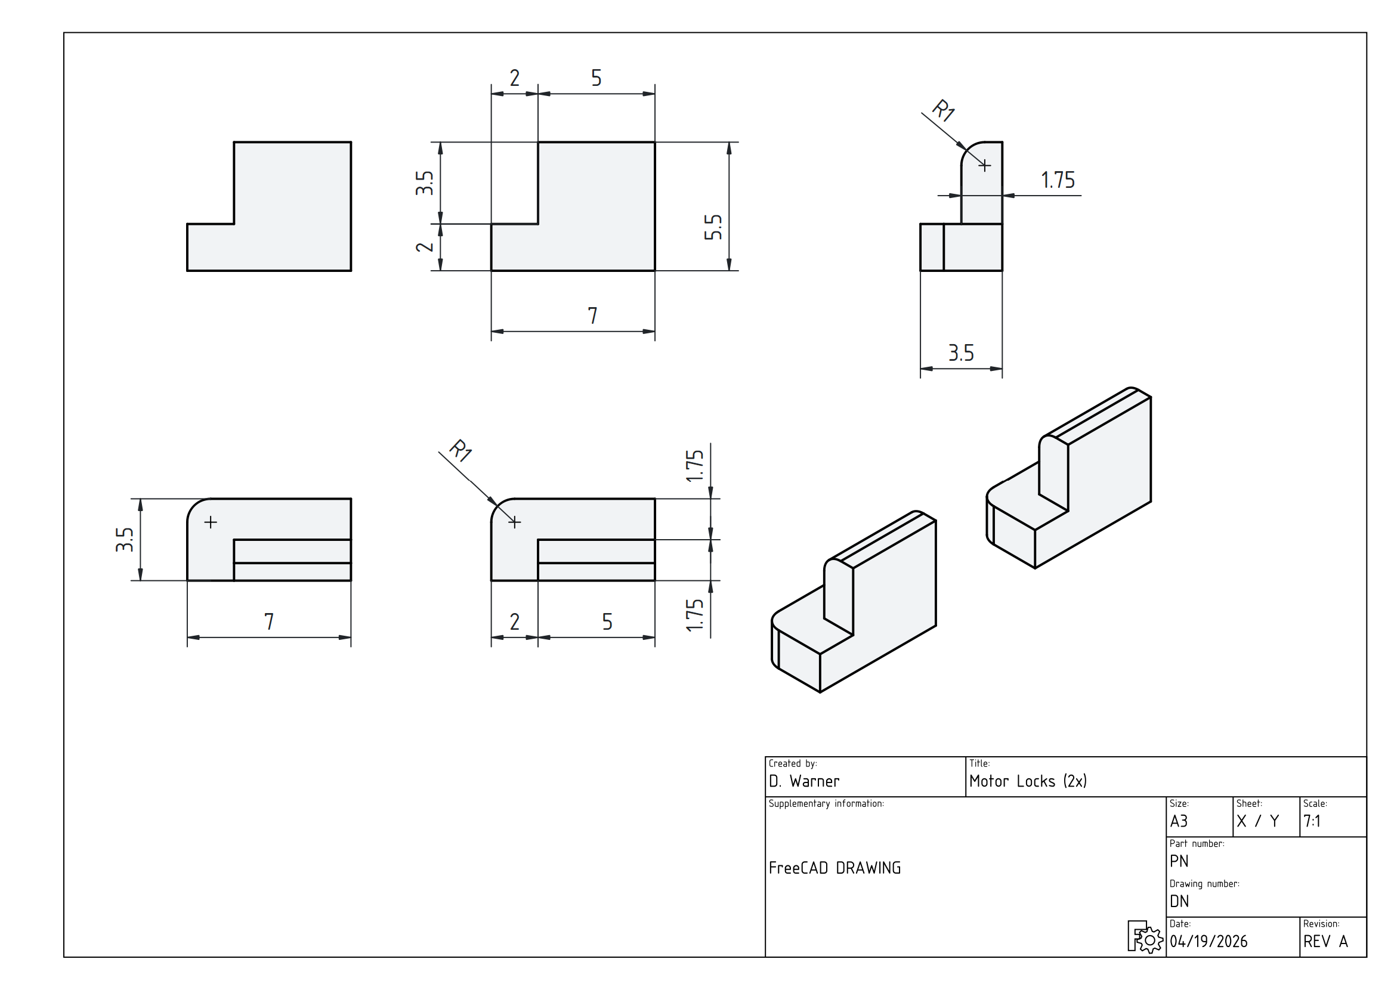
[picture p39: page 33]
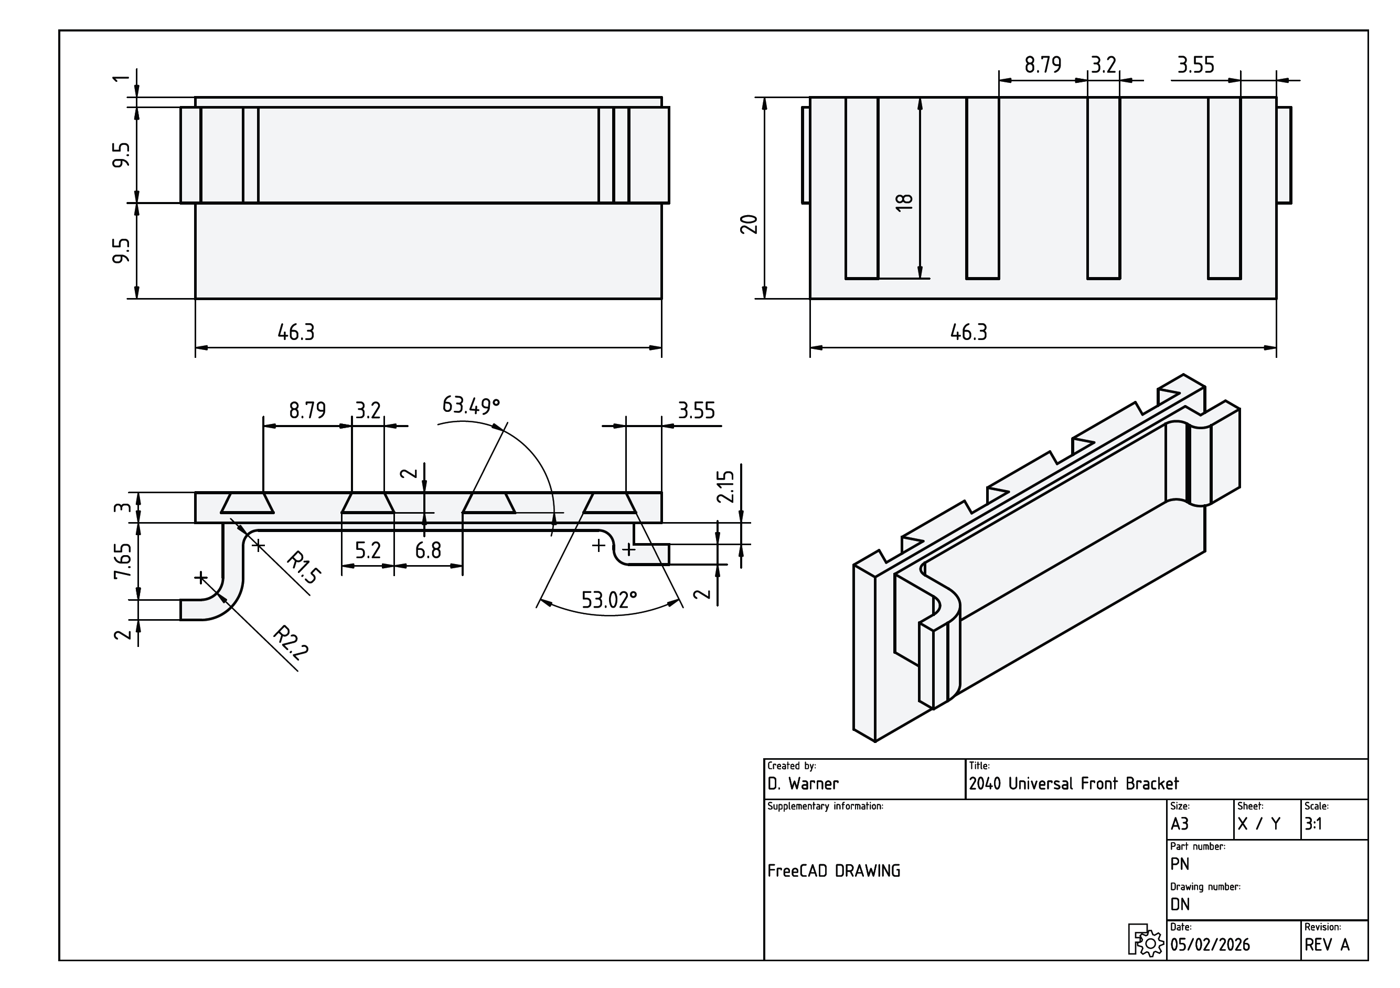
[picture p40: page 34]
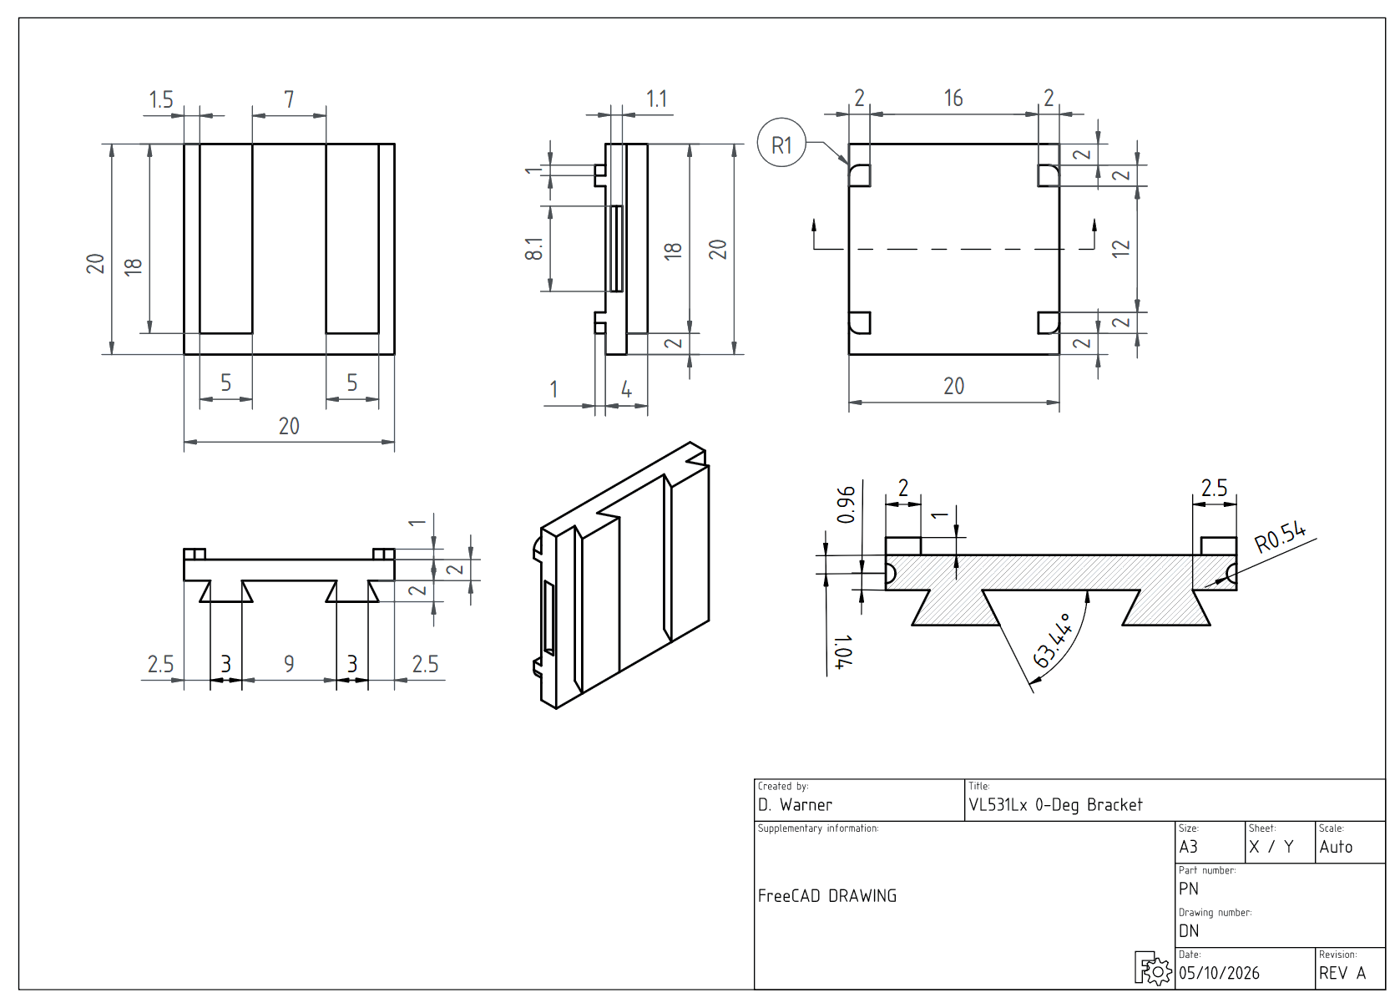
[picture p41: page 35]
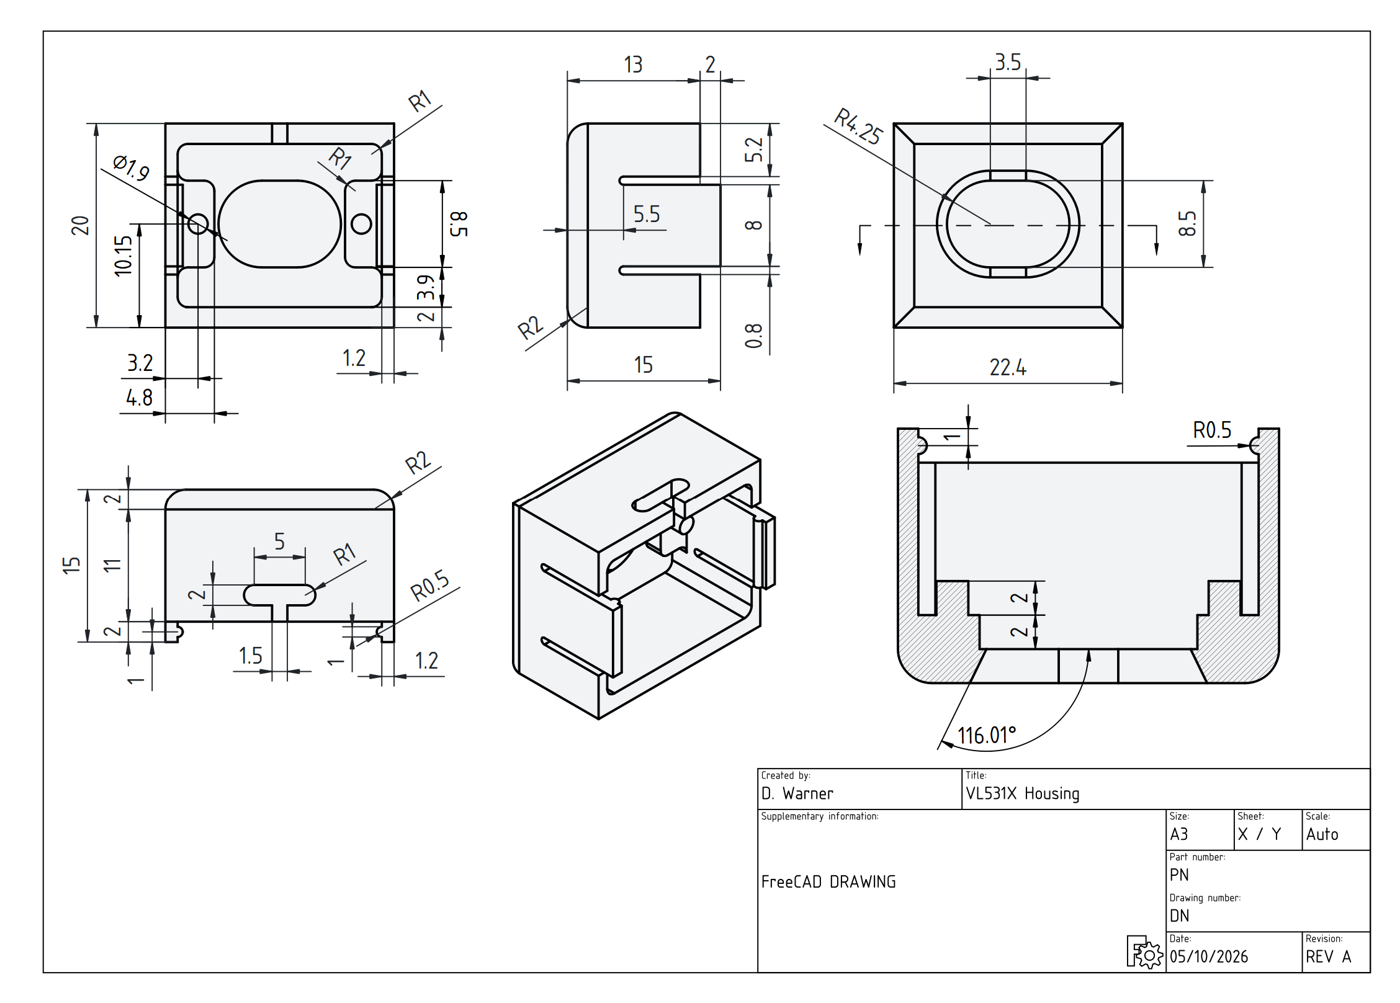
[picture p42: page 36]
