blend3d/Inventor-2040-W/Build and Part Info/Inventor 2040 W Schematic.pdf

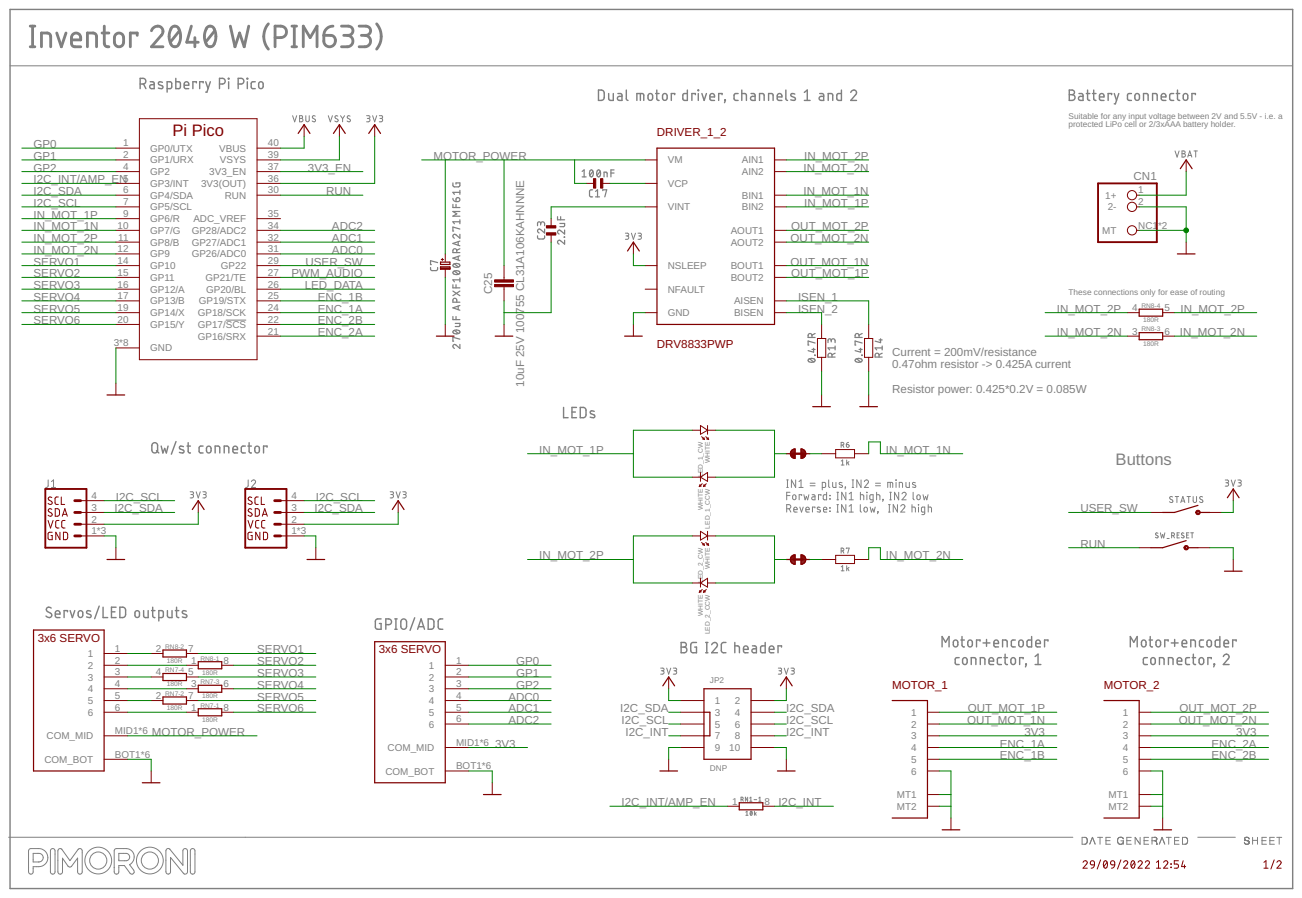
[picture p43: page 1]

Suitable for any input voltage between 2V and 5.5V - i.e. a
protected LiPo cell or 2/3xAAA battery holder.

These connections only for ease of routing

WHITE WHITE

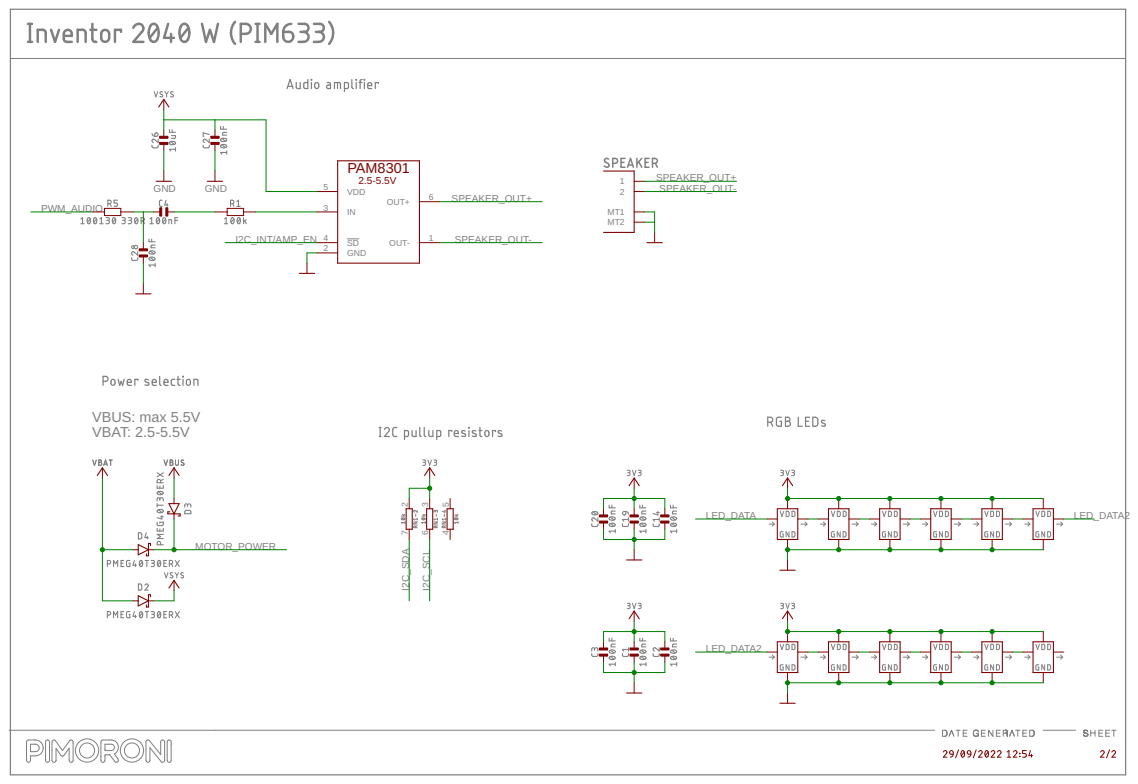
[picture p44: page 2]
