blend3d/Inventor-2040-W/Code/Snippets/WIP_button_press.py

from inventor import Inventor
import time

board = Inventor()

print("Press USER button to start...")

#---------------------------------
# Wait here until the button is pressed
#---------------------------------
try:
    while not board.switch_pressed():	
        # Run "pass" loop until the user button is pressed
        pass

finally:
    # Exit "pass" loop, print message, and insert time delay for switch bounce to settle
    print("USER button pressed, starting code...")
    time.sleep(0.4)		# Time delay of 0.4 seconds

#---------------------------------
# Run code until the user button is pressed
#---------------------------------
try:
    # Run code until the user button is pressed
    while not board.switch_pressed():
        print(board.encoder_a.capture.revolutions_per_second())
        #print("Speed =", capture.revolutions_per_second)

finally:
    # Run Code and Exit
    print("USER button pressed again, exiting program...")
