blend3d/Inventor-2040-W/(commit log)

2026-05-22 STL Files
    STL files customized for Inventor 2040 W SMARS
    [Dave's 2040 24-Deg VL53L1X Mount Bracket.stl, Dave's 2040 Batt Hold w_Locks r1.stl, Dave's 2040 Chassis.stl, Dave's 2040 Sonar Bracket.stl, Dave's 2040 Universal Front Bracket.stl, Dave's 2040 VL53L1X Housing.stl]
2026-05-22 Uploads
    Uploaded build and info pdf, schematic, and basic test code.
2026-08-29 Create BLP2S Inv 2040 Programming Stand.3mf
    [BLP2S Inv 2040 Programming Stand.3mf]
2026-08-29 Programming Stand
    Added a 3d-print programming stand.
    [Dave's 2040 Programming Stand.3mf]
2026-09-28 Update Inventor( ) Object Class Map.xlsx
    Added data to spreadsheet
    [Inventor( ) Object Class Map.xlsx]
